luigismith/ichosynth/docs/README.md

# 📖 docs

| Folder | What |
|---|---|
| [`manuals/`](manuals) | the three manuals, each in **English** and **Italian**, as Markdown and PDF |
| [`wiring/`](wiring) | 🔌 the illustrated wiring guide [`CABLAGGIO.pdf`](wiring/CABLAGGIO.pdf) (Italian), every wire drawn on the real parts |
| [`reference/`](reference) | 🎛️ [control map](reference/MAPPA_CONTROLLI.md) and [feature inventory](reference/FEATURE_INVENTORY.md) |
| [`workshop/`](workshop) | 🎓 ICHOS 2026 workshop material: slides, handout, teacher notes |
| [`HANDOFF.md`](HANDOFF.md) | notes for whoever picks the project up (Italian) |

| Manual | 🇬🇧 English | 🇮🇹 Italiano |
|---|---|---|
| 🔧 **Build**: parts, soldering, wiring, case, firmware | [read](manuals/BUILD_MANUAL.md) · [PDF](manuals/BUILD_MANUAL.pdf) | [leggi](manuals/MANUALE_COSTRUZIONE.md) · [PDF](manuals/MANUALE_COSTRUZIONE.pdf) |
| 🎛️ **Usage**: how to play it | [read](manuals/USAGE_MANUAL.md) · [PDF](manuals/USAGE_MANUAL.pdf) | [leggi](manuals/MANUALE_USO.md) · [PDF](manuals/MANUALE_USO.pdf) |
| 💻 **Dev environment**: build the firmware yourself | [read](manuals/DEV_ENVIRONMENT.md) · [PDF](manuals/DEV_ENVIRONMENT.pdf) | [leggi](manuals/MANUALE_AMBIENTE.md) · [PDF](manuals/MANUALE_AMBIENTE.pdf) |

The case assembly guide (pictures only) lives with the case: [`case/MONTAGGIO.pdf`](../case/MONTAGGIO.pdf).
The PDFs are rebuilt from the Markdown by [`tools/pdf/`](../tools/pdf).
