luigismith/ichosynth/docs/workshop/README.md

# 🎓 Workshop ICHOS 2026: materiali

Materiali della giornata di costruzione di **ICHOS 2026** (Taranto, 12 giugno 2026), in italiano.

| File | Per chi | Cosa |
|---|---|---|
| [`ICHOSYNTH_Costruzione.pptx`](ICHOSYNTH_Costruzione.pptx) | docente | slide della giornata, con le note per il relatore |
| [`APPUNTI_DOCENTE.md`](APPUNTI_DOCENTE.md) · [PDF](APPUNTI_DOCENTE.pdf) | docente | scaletta e promemoria in un foglio |
| [`FASCICOLO_CORSISTA.pdf`](FASCICOLO_CORSISTA.pdf) | corsisti | il fascicolo da consegnare |
| [`QUICKSTART_COSTRUZIONE.md`](QUICKSTART_COSTRUZIONE.md) · [PDF](QUICKSTART_COSTRUZIONE.pdf) | corsisti | la checklist da tenere sul banco |
| [`INTRO_TEENSY_E_CODICE.md`](INTRO_TEENSY_E_CODICE.md) · [PDF](INTRO_TEENSY_E_CODICE.pdf) | corsisti | cos'è un Teensy e come si legge il codice, per chi parte da zero |

Le guide complete sono nei [manuali](..) (costruzione e uso), nella
[guida illustrata al cablaggio](../wiring/CABLAGGIO.pdf) e nella
[guida al montaggio del case](../../case/MONTAGGIO.pdf).
