luigismith/ichosynth/docs/workshop/QUICKSTART_COSTRUZIONE.md

# 🛠️ ichosynth — Quick-start da banco

### Guida rapida di costruzione · ICHOS 2026 · Taranto

> Tienila accanto al banco. Spunta ogni casella man mano. La guida completa è nel
> **Manuale di Costruzione**; qui c'è solo l'essenziale per montare e accendere.

---

## ✅ 1 · Componenti sul banco (BOM)

- [ ] **Teensy 4.1** con **PSRAM** (2× 8 MB) già saldata — *obbligatoria* (TŒRN usa ~16,5 MB)
- [ ] **Teensy Audio Adaptor Rev D** (codec SGTL5000 + jack 3,5 mm)
- [ ] **Matrice LED WS2812B 16×16** (256 LED)
- [ ] **4 encoder KY-040** (E1 · E2 · E3 · E4)
- [ ] **3 tact switch** 6×6 momentanei (PLAY · MENU · REC) — **alti 4,3 mm** se usi il case
- [ ] **1 jack mono 6,35 mm** (LINE IN, per registrare) → pad LINE IN L della scheda audio
- [ ] *(facoltativo)* **case stampato 3D** → `case/MONTAGGIO.pdf` (+ 8 viti M3×8 svasate, 4 piedini)
- [ ] **OLED SSD1306 0,96" I2C** (HUD di stato)
- [ ] **micro SD** Class 10, ≤ 32 GB, **FAT32**
- [ ] **cavo micro-USB dati** + alimentatore 5V ≥ 2A
- [ ] **cuffie** con jack 3,5 mm (niente altoparlanti a bordo)
- [ ] filo AWG 26 colorato, 2 strisce di header maschi **lunghi**, 2 morsetti a leva (WAGO 221) per 3V3/GND
- [ ] 📄 **guida illustrata al cablaggio: `docs/wiring/CABLAGGIO.pdf`** (un filo alla volta)

---

## 📌 2 · Mappa pin (la "verità" del firmware)

```
LED matrix DIN ........... 17          Audio MCLK ... 23    Audio SDA ... 18
                                       Audio BCLK ... 21    Audio SCL ... 19
Encoder E1   CLK 5   DT 22  SW 15      Audio LRCLK .. 20
Encoder E2   CLK 32  DT 33  SW 41      Audio TX ..... 7
Encoder E3   CLK 9   DT 14  SW 16      Audio RX ..... 8
Encoder E4   CLK 37  DT 38  SW 39      OLED ......... SDA 18 / SCL 19 (0x3C)
Pulsanti     PLAY 25   MENU 26   REC 28   →  l'altro capo a GND
```

⚡ **Alimentazioni:** matrice = **5V** · encoder/OLED/audio = **3,3V** · **GND sempre in comune.**
Encoder: pin **"+" → 3,3V**, **GND → GND**. (La 2ª striscia LED reattiva di TŒRN
**non si monta** in questa build: pin 24 libero.)

---

## 🔌 3 · Montaggio passo-passo

**Fase 1 — Teensy**
- [ ] PSRAM saldata (o Teensy che la ha già) · header saldati
- [ ] collega USB → il PC lo riconosce

**Fase 2 — Scheda audio**
- [ ] **impila** la scheda audio sul Teensy (più semplice) *oppure* cabla i segnali (7,8,20,21,23,18,19)
- [ ] cuffie nel jack 3,5 mm

**Fase 3 — Matrice LED**
- [ ] trova la **freccia di INGRESSO** dati → pin **17** (l'uscita resta libera)
- [ ] **5V** e **GND** della matrice

**Fase 4 — Encoder ×4** (E1 → E2 → E3 → E4)
- [ ] per ognuno: CLK, DT, SW come da mappa + "+" (3,3V) e GND
- [ ] etichetta i fili: **incrociare CLK/DT è l'errore #1** (gira al contrario → si scambiano)

**Fase 5 — Pulsanti ×3 e OLED**
- [ ] pulsanti: un capo a **25 (PLAY) / 26 (MENU) / 28 (REC)**, l'altro a **GND** (pull-up interno, niente resistenze)
- [ ] OLED in parallelo su SDA 18 / SCL 19, VCC 3,3V, GND

**Fase 6 — Controllo prima di accendere** 🔴
- [ ] multimetro: **nessun corto** 5V–GND e 3,3V–GND
- [ ] 5V / 3,3V / GND nei pin giusti

---

## ⚡ 4 · Caricare il firmware (flasher in un clic)

- [ ] collega il Teensy via USB
- [ ] apri **`tools/flasher/flasher.exe`** (al primo avvio Windows SmartScreen → *Ulteriori informazioni → Esegui comunque*)
- [ ] premi **⚡ Flash ichosynth**
- [ ] quando l'app lo chiede, premi una volta il **pulsantino PROGRAM** sul Teensy
- [ ] attendi *"Firmware scritto e Teensy riavviato"* ✅

> Niente Arduino/arduino-cli per chi flasha: il firmware ichosynth (TŒRN) è già
> dentro l'app. Per ricompilarlo dai sorgenti: `python firmware/build_toern.py`
> (vedi `firmware/README.md`).

---

## 💾 5 · Preparare la SD (campioni)

- [ ] modo più rapido: copia il contenuto di **`sdcard/`** sulla radice della SD (set già pronto)
- [ ] oppure apri **`tools/wavmaker/wavmaker.exe`** → **🔍 Scansiona** la SD (formatta FAT32 se serve)
- [ ] scegli **modalità**: *Samplepack* (8 voci → `<pack>/1-8.wav`) o *Libreria* (`samples/<cat>/<nome>.wav`)
- [ ] **Aggiungi file/cartella** WAV → **Converti** (diventano mono · 16-bit · 44.1 kHz)

---

## ▶️ 6 · Primo avvio

- [ ] SD inserita · cuffie · alimenta via USB → **logo** sulla matrice
- [ ] icona **noSD** rossa? spegni, inserisci la SD, riaccendi
- [ ] muovi gli encoder → il cursore e i parametri rispondono (l'OLED mostra canale/modo/BPM)
- [ ] piazza una nota sulla griglia → senti il campione
- [ ] premi **PLAY** → la sequenza parte; **MENU** entra/esce dai menu; **REC** registra
- [ ] in DRAW, **ruota E4**: il suono della voce sotto il cursore si scurisce (filtro lowpass)

---

## 🆘 7 · Se qualcosa non va (top 5)

| Sintomo | Rimedio rapido |
|---|---|
| Non riconosciuto dal PC | cavo USB **dati** (non solo-carica); ricontrolla header / corto 5V-GND |
| Si riavvia da solo | PSRAM mancante/mal saldata (servono i 2 chip); alimentazione 5V ≥ 2A; **SD inserita** |
| LED spenti / colori errati | DIN non sul **17**; freccia dati invertita; GND non comune |
| Encoder "al contrario" | inverti **CLK e DT** di quell'encoder |
| Nessun suono | scheda audio (7,8,20,21,23,18,19); cuffie; volume |

---

<div align="center">

**Quando suona → Manuale d'Uso.** Buona costruzione! 🎛️
*ichosynth · build a basso costo di TŒRN (SP_) · firmware MIT*

</div>
