luigismith/ichosynth/design/foundations/typography.html

Tipografia

ichosynth

Titolo sezione (Segoe UI 700)

Sottotitolo / didascalia (Segoe UI, #9aa4b2)

Testo corrente. Il sistema usa Segoe UI per l'interfaccia e la documentazione, con un grigio tenue per le note secondarie.

Monospace — pin e codice

E1 5 / 22 / 15 E4 37 / 38 / 39 pulsanti 25 / 26 / 28

python firmware/build_toern.py → toern.hex
