luigismith/ichosynth/design/brand/logo.html

Logo / Lockup

🎛️ ichosynth

un TŒRN su hardware DIY · Teensy 4.1
