luigismith/ichosynth/assets/social-preview.jpg

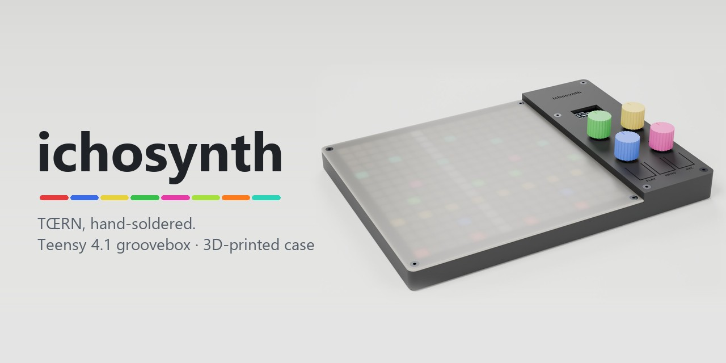
assets/social-preview.jpg
