luigismith/ichosynth/_DOCS/_PCB/ni404/production/bom.csv

Designator | Footprint | Quantity | Value | LCSC Part #
J11, J12, J13, J14, J15 | JST_PH_B5B-PH-K_1x05_P2.00mm_Vertical | 5 | Conn_01x05
J9 | JST_PH_B3B-PH-K_1x03_P2.00mm_Vertical | 1 | Conn_01x03
