luigismith/ichosynth/_DOCS/_PCB/ni404/ni404.csv

Id | Designator | Footprint | Quantity | Designation | Supplier and ref
1 | J15,J11,J12,J13,J14 | JST_PH_B5B-PH-K_1x05_P2.00mm_Vertical | 5 | Conn_01x05
2 | J9 | JST_PH_B3B-PH-K_1x03_P2.00mm_Vertical | 1 | Conn_01x03
