luigismith/ichosynth/_DOCS/_ENCLOSURE/ni404 completed.stl

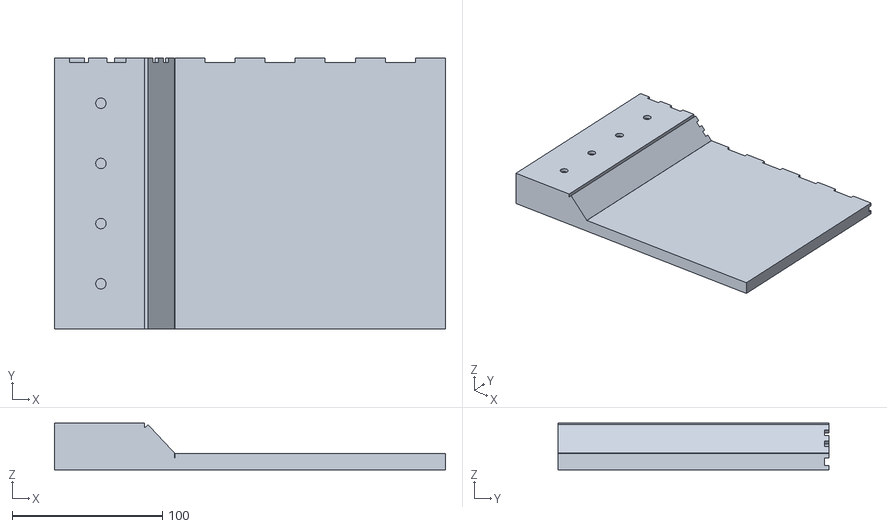
[picture p45: CAD file, 2026-05-21]
_DOCS/_ENCLOSURE/ni404 completed.stl
260.0 x 180.0 x 31.0
