luigismith/ichosynth/_CASE/stl/tray.stl

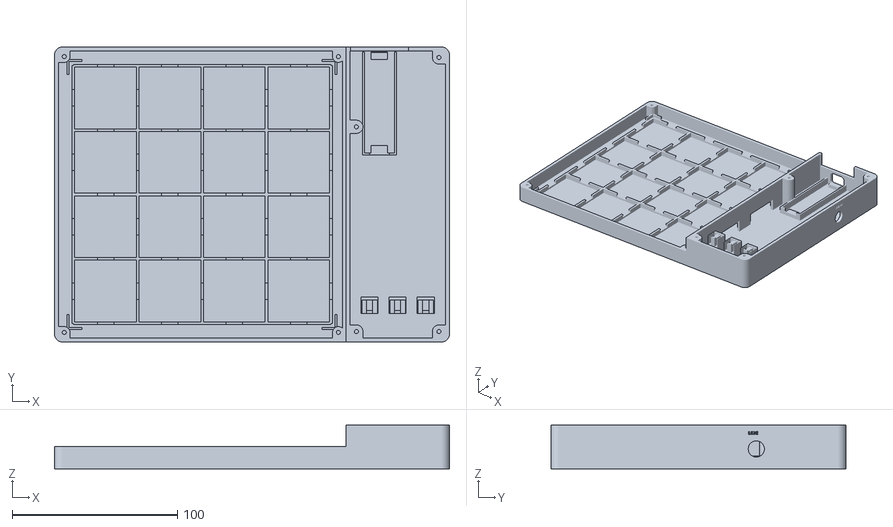
[picture p46: CAD file, 2026-10-30]
_CASE/stl/tray.stl
239.2 x 178.8 x 26.4
