luigismith/ichosynth/_DOCS/_ENCLOSURE/ni404_front.stl

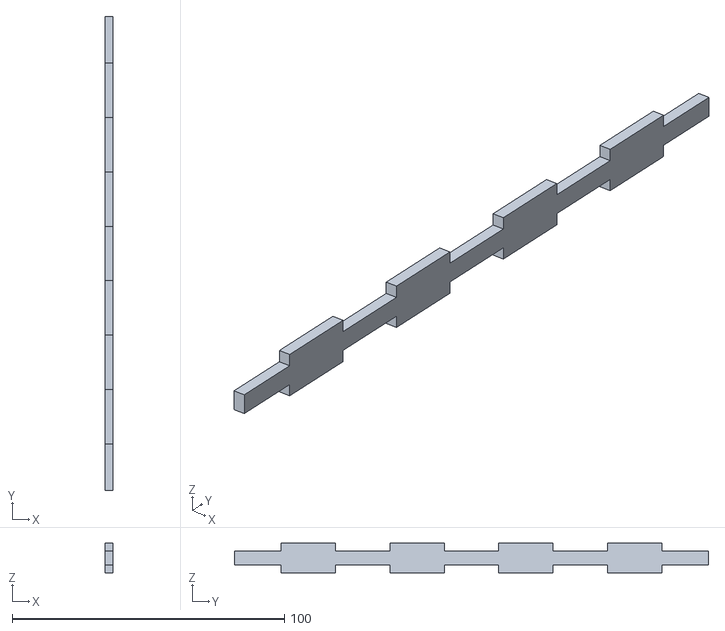
[picture p47: CAD file, 2026-05-21]
_DOCS/_ENCLOSURE/ni404_front.stl
3.00 x 174.0 x 11.0
