luigismith/ichosynth/_DOCS/_PCB/ni404/ni404.step

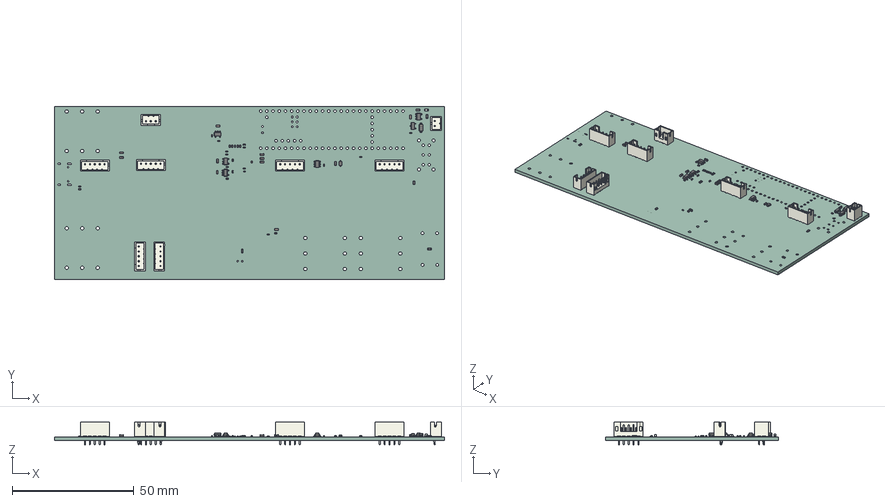
[picture p48: CAD file, 2026-05-21]
_DOCS/_PCB/ni404/ni404.step
160.0 x 71.0 x 9.40 mm
D_SOD_123
C_0402_1005Metric x 14
R_0603_1608Metric x 6
R_0402_1005Metric x 11
JST_B5B_PH_K x 6
C_0603_1608Metric x 10
SOT_23_6
SOT_23_5 x 4
JST_B3B_PH_K
LED_0603_1608Metric
SOT_23
JST_B2B_PH_K
D_SOD_323F
teensyAudioMidi_PCB
