luigismith/ichosynth/case/ichosynth_case_S1Combo_PETG.3mf

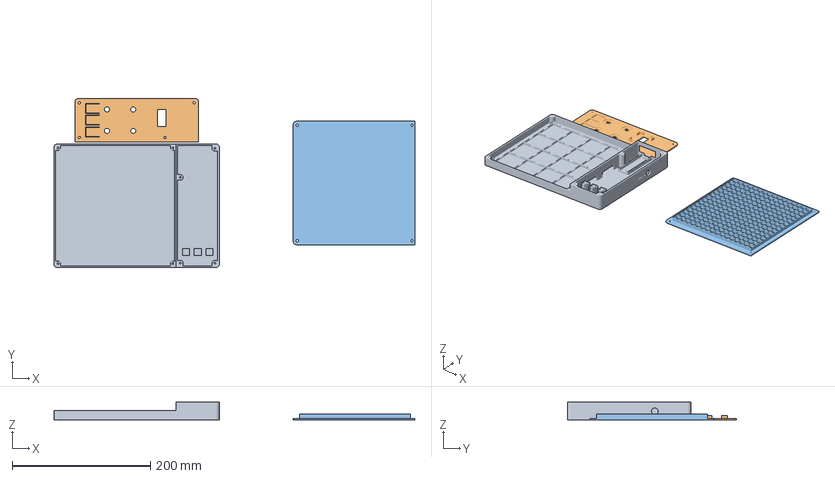
[picture p49: CAD file, 2026-11-05]
case/ichosynth_case_S1Combo_PETG.3mf
522.1 x 244.6 x 26.0 mm
vasca
pannello
diffusore
