luigismith/ichosynth/_CASE/stl/plate1.stl

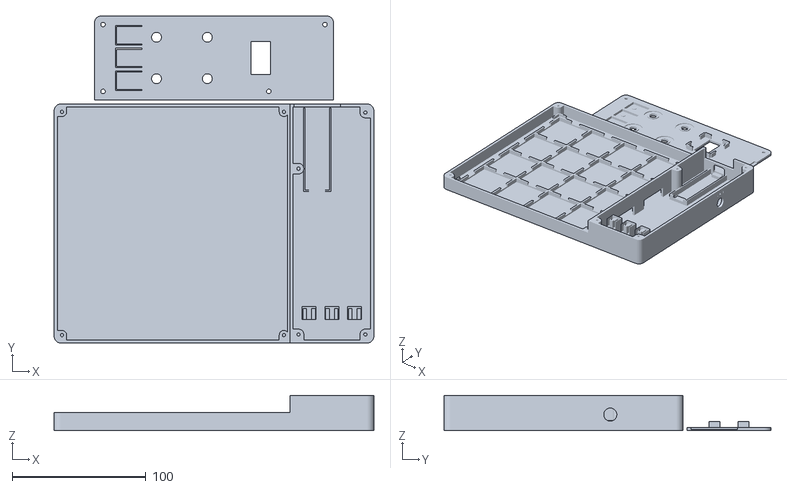
[picture p50: CAD file, 2026-10-30]
_CASE/stl/plate1.stl
239.2 x 244.6 x 26.4
