luigismith/ichosynth/_CASE/stl/window.stl

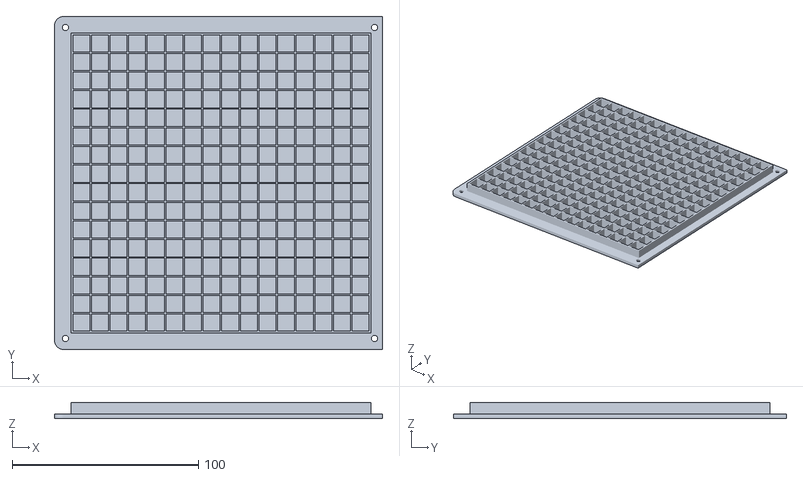
[picture p51: CAD file, 2026-10-30]
_CASE/stl/window.stl
176.2 x 178.8 x 8.60
