luigismith/ichosynth/_DOCS/_ENCLOSURE/ni404_frontplate.stl

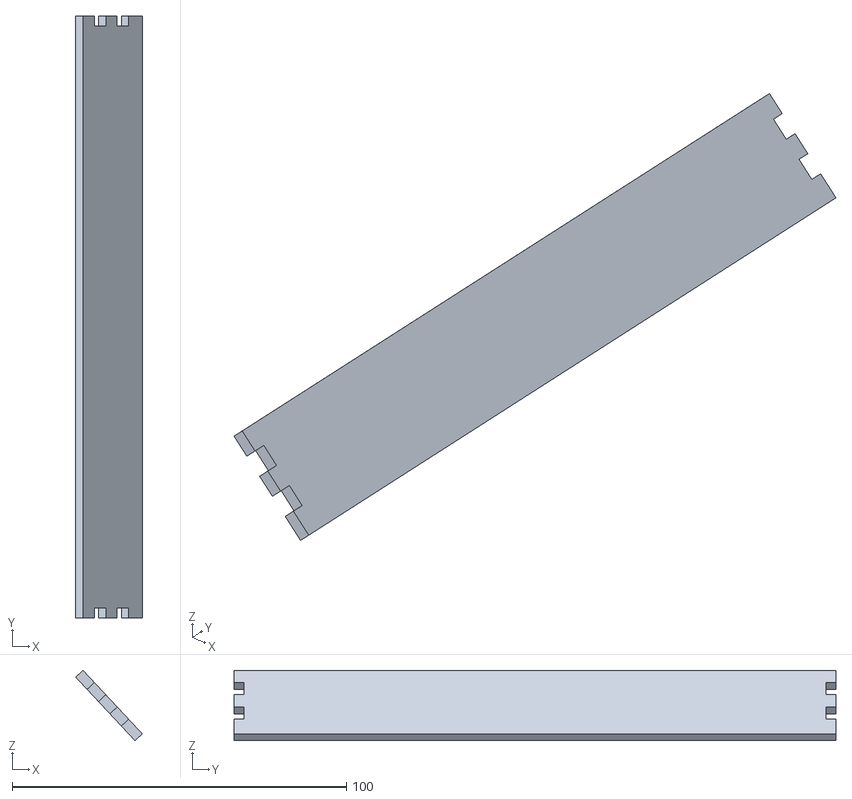
[picture p52: CAD file, 2026-05-21]
_DOCS/_ENCLOSURE/ni404_frontplate.stl
19.9 x 180.0 x 21.1
