luigismith/ichosynth/case/stl/panel.stl

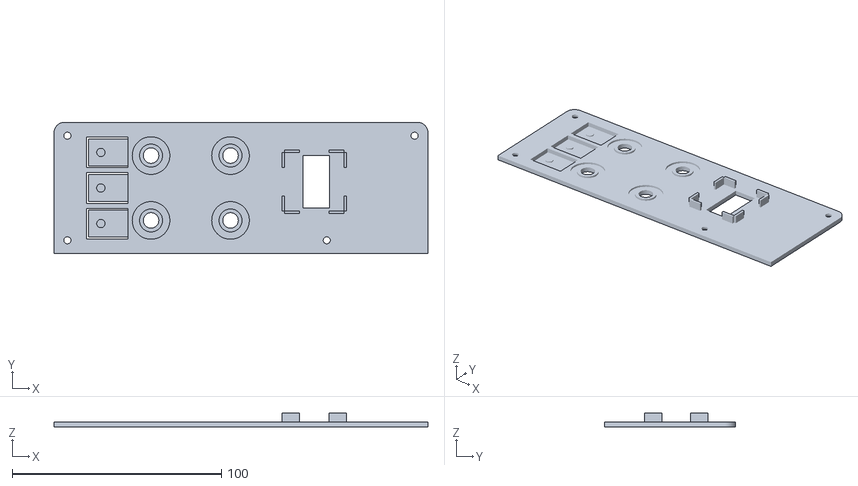
[picture p53: CAD file, 2026-11-04]
case/stl/panel.stl
178.8 x 62.8 x 6.70
