luigismith/ichosynth/_CASE/stl/knob.stl

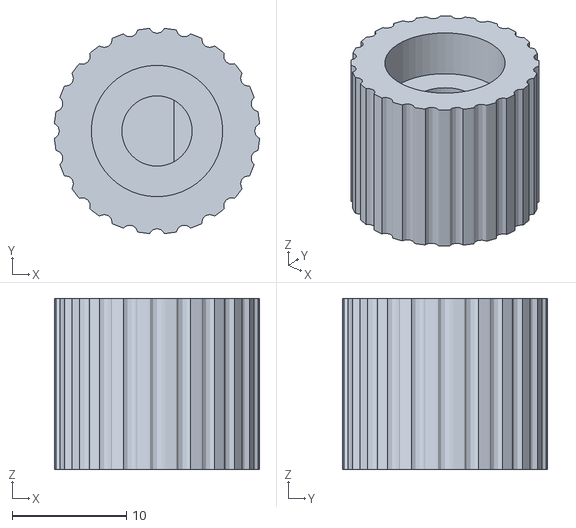
[picture p54: CAD file, 2026-10-30]
_CASE/stl/knob.stl
17.9 x 17.9 x 15.0
