luigismith/ichosynth/_DOCS/_ENCLOSURE/ni404_top.stl

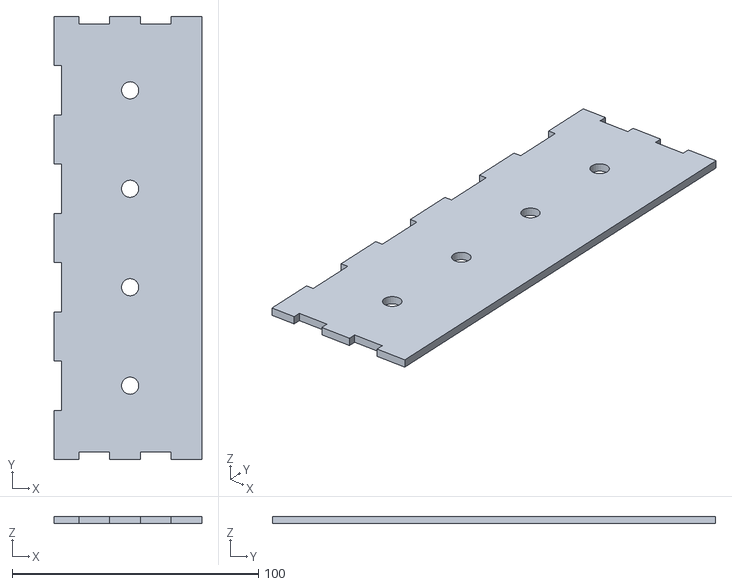
[picture p55: CAD file, 2026-05-21]
_DOCS/_ENCLOSURE/ni404_top.stl
60.0 x 180.0 x 3.00
