luigismith/ichosynth/_DOCS/_ENCLOSURE/ni404_back.stl

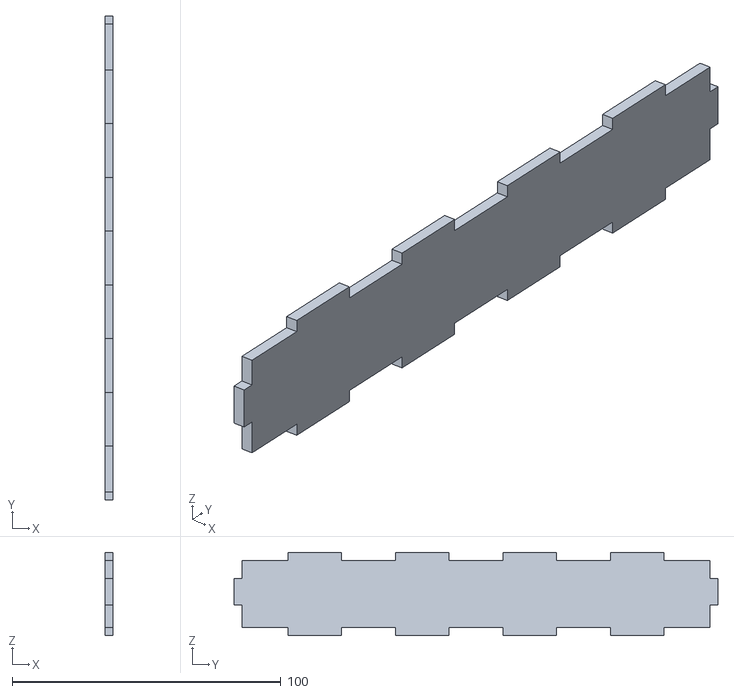
[picture p56: CAD file, 2026-05-21]
_DOCS/_ENCLOSURE/ni404_back.stl
3.00 x 180.0 x 31.0
