luigismith/ichosynth/_DOCS/_ENCLOSURE/ni404_glassplate.stl

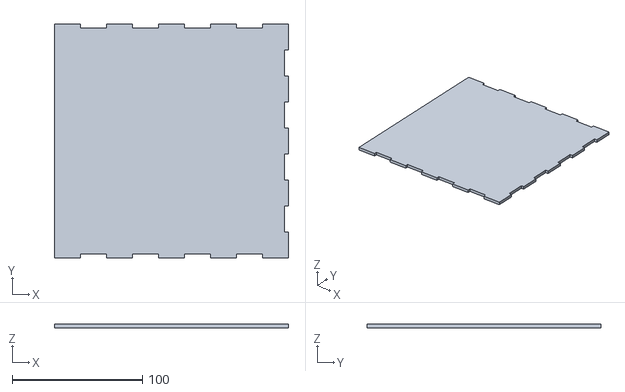
[picture p57: CAD file, 2026-05-21]
_DOCS/_ENCLOSURE/ni404_glassplate.stl
180.0 x 180.0 x 3.00
