luigismith/ichosynth/_DOCS/_ENCLOSURE/ni404_base.stl

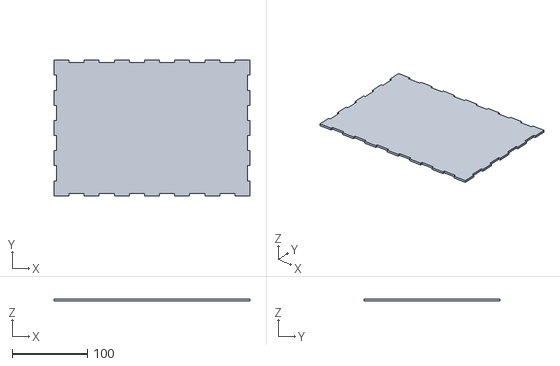
[picture p58: CAD file, 2026-05-21]
_DOCS/_ENCLOSURE/ni404_base.stl
260.0 x 180.0 x 3.00
