luigismith/ichosynth/_DOCS/_ENCLOSURE/ni404_sides.stl

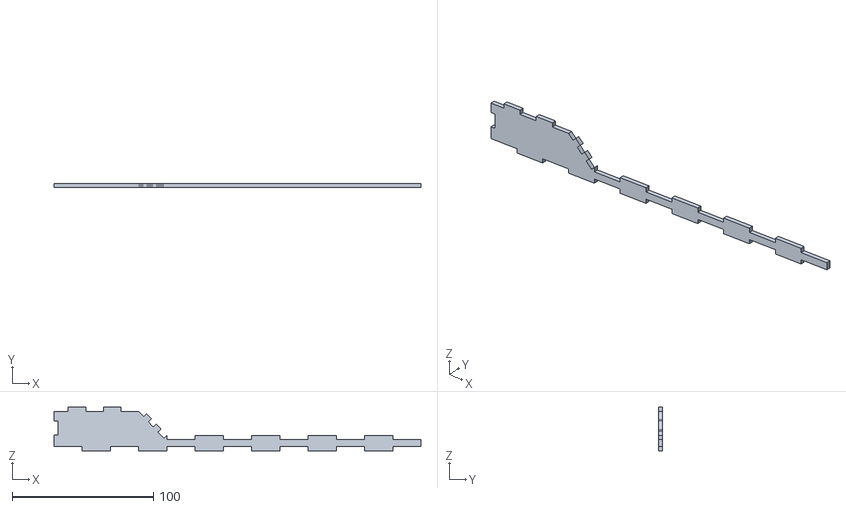
[picture p59: CAD file, 2026-05-21]
_DOCS/_ENCLOSURE/ni404_sides.stl
260.0 x 3.00 x 31.0
