luigismith/ichosynth/_DOCS/_ENCLOSURE/ni_404.dxf

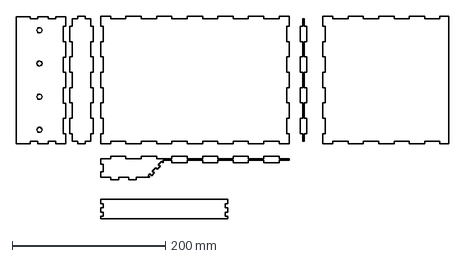
[picture p60: CAD file, 2026-05-21]
_DOCS/_ENCLOSURE/ni_404.dxf
564.2 x 264.5 mm
