luigismith/ichosynth/(list of files, cad)

Other CAD files:
case/stl/tray.stl
case/ichosynth_case_S1Combo.3mf
case/stl/plate1.stl
_CASE/ichosynth_case_S1Combo.3mf
_CASE/ichosynth_case_S1Combo_PETG.3mf
_DOCS/_ENCLOSURE/ni_404.f3d
