luigismith/ichosynth/MANUALE_AMBIENTE.md

**🇮🇹 Italiano** · [🇬🇧 English](DEV_ENVIRONMENT.md)

<div align="center">

# 💻 ichosynth — Ambiente di sviluppo

### Guida completa e aggiornata per Windows e macOS

Tutto il necessario per compilare, modificare e caricare il firmware: dalla toolchain alle librerie, fino al primo upload sul Teensy 4.1.






</div>

> ⚡ **Hai fretta?** ichosynth esegue il firmware reale **TŒRN**, e un solo comando lo compila per il nostro
> hardware: `python teensy/build_toern.py`. Vai al [capitolo 3](#3--via-rapida-un-comando-compila-tutto). Il
> resto della guida spiega ogni passo e prerequisito.

---

## 📑 Indice

- [1 · Cosa installiamo](#1--cosa-installiamo)
- [2 · Requisiti](#2--requisiti)
- [3 · Via rapida: un comando compila tutto](#3--via-rapida-un-comando-compila-tutto)
- [4 · Installare la toolchain (arduino-cli)](#4--installare-la-toolchain-arduino-cli)
- [5 · Aggiungere il supporto Teensy (il core teensy:avr)](#5--aggiungere-il-supporto-teensy-il-core-teensyavr)
- [6 · Le librerie](#6--le-librerie)
- [7 · Come funziona lo script di build](#7--come-funziona-lo-script-di-build)
- [8 · Compilare e caricare](#8--compilare-e-caricare)
- [9 · Compilare dall'Arduino IDE (alternativa)](#9--compilare-dallarduino-ide-alternativa)
- [10 · Strumenti opzionali (Python, Git)](#10--strumenti-opzionali-python-git)
- [11 · Checklist e problemi comuni](#11--checklist-e-problemi-comuni)

---

## 1 · Cosa installiamo

ichosynth è un **Teensy 4.1** che esegue il firmware reale **TŒRN** (di SP_ / soundpauli — <https://toern.live>)
su componenti economici saldati a mano. Nel repo non teniamo una copia separata di TŒRN: uno script di build
scarica i sorgenti originali e li compila per il nostro hardware. Ecco cosa serve:

| Componente | Versione | A cosa serve | Obbligatorio |
|---|---|---|---|
| **arduino-cli** | ultima | la toolchain di build da riga di comando | ✅ |
| **core teensy:avr** | **≥ 1.61.0** | il compilatore Teensy + il Teensy Loader | ✅ |
| **Python** | 3.x | esegue `teensy/build_toern.py` (lo script di build) | ✅ |
| **Git** | ultima | lo script clona i sorgenti TŒRN alla prima esecuzione | ✅ |
| **Driver personalizzati** | nel repo | `i2cEncoderLibV2`, `FastTouch`, `IchosOled` — già in `teensy/libraries/` | ✅ (inclusi) |
| **GitHub CLI** | ultima | opzionale, per versionare il progetto | opzionale |

> ⚙️ **L'unica trappola che frega tutti:** TŒRN è un'unica unità di compilazione da ~23k righe, e il gcc del
> Teensy **va in crash con il `-O2` di default** (esce con `0xffffffff` — un internal compiler error /
> out-of-memory). La soluzione è compilare a **`-O1`** (`opt=o1std`). Lo script di build lo imposta per te; se
> invece compili dall'Arduino IDE devi scegliere **Tools → Optimize → "Fast"**. Vedi il
> [capitolo 7](#7--come-funziona-lo-script-di-build).

---

## 2 · Requisiti

- **Windows**: Windows 10 o 11, 64 bit.
- **macOS**: macOS 10.15 o successivo; supporto nativo **Intel** e **Apple Silicon** (M1/M2/M3/M4).
- **Cavo micro-USB dati** (non solo-carica) per il Teensy 4.1.
- Un **Teensy 4.1 con 16 MB di PSRAM** (entrambi i chip) saldati — TŒRN usa la PSRAM per i buffer dei campioni.
- ~1 GB di spazio su disco per toolchain + core + librerie.

---

## 3 · Via rapida: un comando compila tutto

Una volta che hai **arduino-cli**, il **core teensy:avr**, **Python** e **Git** (capitoli 4–5), compilare il
firmware è un solo comando dalla radice del repo:

```bash
python teensy/build_toern.py
```

Questo produce il firmware in **`teensy/firmware/toern.hex`**. Per compilare *e* flashare in un colpo solo (se
`teensy_loader_cli` è nel tuo PATH):

```bash
python teensy/build_toern.py --flash
```

Flag utili:

| Flag | Effetto |
|---|---|
| `--flash` | dopo la compilazione, carica con `teensy_loader_cli` |
| `--keep` | mantiene la cartella di build temporanea (per ispezionare i sorgenti preparati/patchati) |

> 💡 La **prima** compilazione è lenta (il core Teensy viene compilato una volta) e inoltre **clona i sorgenti
> TŒRN** in `emulator/toern-src/` se non ci sono ancora. Le compilazioni successive sono rapide.
>
> 🖱️ Vuoi solo flashare un `.hex` **già pronto**? C'è un flasher GUI a un clic in **`_FLASHER/`** — vedi il
> [capitolo 8.3](#83-flashare-il-firmware).

---

## 4 · Installare la toolchain (arduino-cli)

Compiliamo da riga di comando con **[`arduino-cli`](https://arduino.github.io/arduino-cli/)**.

### Windows
```powershell
winget install ArduinoSA.CLI
```

### macOS
```bash
brew install arduino-cli
```

Verifica che sia nel PATH:
```bash
arduino-cli version
```

> ℹ️ **Driver**: su Windows 10/11 e su macOS **non servono driver aggiuntivi** per il Teensy 4.1.

---

## 5 · Aggiungere il supporto Teensy (il core teensy:avr)

Il compilatore Teensy e il Teensy Loader arrivano dal **core teensy:avr**. Aggiungi l'indice dei pacchetti di
PJRC, aggiorna e installa il core (ci serve la **versione ≥ 1.61.0**):

```bash
arduino-cli config init
arduino-cli config add board_manager.additional_urls https://www.pjrc.com/teensy/package_teensy_index.json
arduino-cli core update-index
arduino-cli core install teensy:avr
```

Controlla la versione che hai ottenuto:
```bash
arduino-cli core list
```
Dovresti vedere `teensy:avr` alla **1.61.0** o successiva.

> 💡 Preferisci una GUI? In alternativa puoi installare **Teensyduino 1.61** dal Boards Manager dell'Arduino
> IDE 2.x (URL del pacchetto PJRC qui sopra): installa lo stesso core `teensy:avr`. In entrambi i casi, allo
> script di build serve solo che il core sia presente e `arduino-cli` nel PATH.

---

## 6 · Le librerie

Il firmware TŒRN si compila contro tre **driver personalizzati** che lo adattano al nostro hardware economico.
Sono **già nel repo** sotto `teensy/libraries/`, e lo script di build li indica ad `arduino-cli`
automaticamente — non devi installarli:

| Libreria | Sostituisce | Dove sta la configurazione hardware |
|---|---|---|
| **i2cEncoderLibV2** | i 4 encoder RGB I²C di TŒRN → i nostri 4 encoder meccanici KY-040 | `ICHOS_ENC_PINS` in `i2cEncoderLibV2.h` |
| **FastTouch** | i 3 pad capacitivi di TŒRN → i nostri 3 pulsanti tattili momentanei | `ICHOS_BTN_PINS` in `FastTouch.h` |
| **IchosOled** | aggiunge l'**HUD OLED** I²C (lo stato che TŒRN mostrava sugli anelli RGB degli encoder) | `teensy/libraries/IchosOled/` |

> 🧭 **Dove vive l'hardware:** l'assegnazione dei pin sta in quei due header (`ICHOS_ENC_PINS`,
> `ICHOS_BTN_PINS`) e in `teensy/build_toern.py` — **non** in un `config.h`. (`config.h` appartiene alla vecchia
> build di fallback NI404 e non viene usato dal port TŒRN.)

Lo script di build risolve anche le eventuali librerie standard rimanenti (le **Audio**, **Wire**, **SD**, ecc.
incluse nel core Teensy, più qualsiasi cosa nella tua `Arduino/libraries/` utente) come fa normalmente
`arduino-cli`.

---

## 7 · Come funziona lo script di build

`teensy/build_toern.py` compila lo sketch TŒRN **non modificato**, applicando solo le modifiche minime che lo
fanno girare sul nostro hardware. Passo per passo:

1. **Trova i sorgenti.** Cerca lo sketch TŒRN sotto `emulator/toern-src/`; se non c'è, lo **clona**
   automaticamente dall'upstream (così il repo resta privo di una copia interna).
2. **Li prepara** in una cartella di build temporanea (gli originali restano intatti).
3. **Remap dei pin.** I `SWITCH_1/2/3` di TŒRN puntano di default a pin che collidono con il nostro KY-040 di
   destra, quindi vengono rimappati a **25 / 26 / 28** — gli stessi pin di `ICHOS_BTN_PINS` in `FastTouch.h`.
4. **Snellimento funzioni.** Rimuove la **seconda striscia LED** opzionale (libera un pin e risparmia CPU),
   come nel nostro build.
5. **HUD OLED.** Cabla la libreria `IchosOled` (include + `begin()` + una chiamata di rendering su una riga nel
   `loop()`) così che l'HUD di stato compili come unità di compilazione separata.
6. **Compila** con `arduino-cli` per l'FQBN qui sotto e copia il risultato in un nome stabile, `toern.hex`.

Il target esatto per cui compila è:

```text
teensy:avr:teensy41:usb=serialmidi16,opt=o1std
```

- `usb=serialmidi16` → **USB type Serial + MIDIx16** (così `usbMIDI` funziona).
- `opt=o1std` → **`-O1`**. È il flag critico: il `-O2` di default fa crashare il gcc del Teensy sull'enorme
  unità di compilazione singola di TŒRN. Il `-O1` compila pulito e il firmware ci sta comunque con margine.

---

## 8 · Compilare e caricare

### 8.1 Compilare
Dalla radice del repo:
```bash
python teensy/build_toern.py
```
Al termine avrai **`teensy/firmware/toern.hex`**.

### 8.2 Compilare e flashare in un passo
Se hai `teensy_loader_cli` nel PATH:
```bash
python teensy/build_toern.py --flash
```
1. Collega il Teensy 4.1 via USB (cavo **dati**).
2. Il loader di solito programma da solo; se resta in attesa, premi il **pulsantino bianco** sul Teensy.
3. A fine flash parte l'animazione sulla matrice LED.

### 8.3 Flashare il firmware
Se preferisci flashare un `.hex` **già pronto** (o non hai `teensy_loader_cli`), usa il **flasher GUI a un
clic** in **`_FLASHER/`** — puntalo a `teensy/firmware/toern.hex` e clicca flash.

---

## 9 · Compilare dall'Arduino IDE (alternativa)

Puoi anche compilare TŒRN a mano nell'Arduino IDE 2.x — utile per studiare il codice passo passo. Devi
riprodurre quello che fa lo script:

| Voce del menu Tools | Valore |
|---|---|
| **Board** | Teensy 4.1 |
| **USB Type** | **Serial + MIDIx16** |
| **CPU Speed** | 600 MHz (default) |
| **Optimize** | **"Fast"** ⚠️ (è il `-O1`; il default "Faster"/`-O2` fa crashare il compilatore) |
| **Port** | la porta del Teensy (dopo il collegamento) |

Dovrai inoltre applicare il remap dei pin (`SWITCH_1/2/3` → 25/26/28), rendere visibili all'IDE le tre librerie
personalizzate in `teensy/libraries/` e cablare a mano l'HUD OLED. **Lo script fa tutto questo per te**, ed è
per questo che è il percorso consigliato.

> ⚠️ Non dimenticare **Optimize → "Fast"**. Se lo lasci sul default, la build muore con un internal compiler
> error (`exit 0xffffffff`) a metà dell'unico file enorme di TŒRN.

---

## 10 · Strumenti opzionali (Python, Git)

### 10.1 Python
Allo script di build serve **Python 3**. (Serve anche Git — vedi sotto — perché lo script clona i sorgenti
TŒRN alla prima esecuzione.)

**Windows:** `winget install Python.Python.3.12`  · **macOS:** `brew install python@3.12`

> ℹ️ Per lo script di build va bene qualsiasi Python 3 moderno. (Se usi anche il convertitore di campioni
> `wavmaker` e lo esegui dai sorgenti su **Python 3.13+**, quello richiede `pip install audioop-lts`, perché
> `audioop` è stato rimosso dalla libreria standard — ma il `wavmaker.exe` pronto in `_SDCARD/` non richiede
> Python.)

### 10.2 Git e GitHub CLI
Git è obbligatorio (lo script clona TŒRN). GitHub CLI è opzionale.

**Windows:** `winget install Git.Git` (+ `GitHub.cli` opzionale)
**macOS:** `xcode-select --install` (include git) · `brew install gh` (opzionale)

---

## 11 · Checklist e problemi comuni

| ✓ | Controllo |
|---|---|
| ☐ | `arduino-cli version` funziona (è nel PATH) |
| ☐ | `arduino-cli core list` mostra **teensy:avr ≥ 1.61.0** |
| ☐ | **Python 3** e **Git** sono installati |
| ☐ | `python teensy/build_toern.py` produce `teensy/firmware/toern.hex` |
| ☐ | (solo build da IDE) USB Type = Serial + MIDIx16 **e** Optimize = "Fast" |
| ☐ | Il Teensy 4.1 ha **16 MB di PSRAM** saldati |

| Sintomo | Causa / soluzione |
|---|---|
| `arduino-cli not on PATH …` dallo script | installa arduino-cli (cap. 4) e riapri il terminale |
| La compilazione muore con `exit 0xffffffff` / internal compiler error | hai compilato a `-O2`; usa lo script, oppure imposta Optimize → "Fast" (`-O1`) nell'IDE |
| `teensy:avr` mancante / troppo vecchio | esegui `arduino-cli core install teensy:avr` e controlla `core list` (serve ≥ 1.61.0) |
| Lo script non riesce a clonare i sorgenti TŒRN | installa Git, oppure clona a mano in `emulator/toern-src/` |
| `'usbMIDI' was not declared` (build da IDE) | USB Type non su Serial + MIDIx16 |
| `teensy_loader_cli not found` con `--flash` | usa invece il flasher GUI in `_FLASHER/` |
| Il Teensy non si programma | premi il **pulsante bianco** sulla scheda; oppure usa un cavo USB **dati**, non solo-carica |
| Porta non visibile | cavo USB solo-carica → usa un cavo dati |

---

<div align="center">

*Parte del progetto **[ichosynth](README.it.md)** · esegue il firmware reale **TŒRN** (SP_) · per il workshop ICHOS 2026.*

</div>
