luigismith/ichosynth/emulator/MANUALE.md

# Emulatore ichosynth — Manuale utente

Emulatore desktop (Windows e macOS) usato come **banco di prova** per ichosynth.
Esegue un **firmware reale** ricompilato in modo nativo: la stessa logica che gira
sull'hardware, ma sul computer, con la griglia LED 16×16, il display OLED, l'audio
e i controlli su tastiera/mouse e controller MIDI.

> Lo **strumento fisico** ichosynth fa girare il **firmware reale di TŒRN** (si
> compila con `firmware/build_toern.py`). L'emulatore può eseguire **lo stesso
> sorgente TŒRN** nel target `toernemu` (riferimento, §10), utile per provare la
> mappatura dei controlli prima dell'hardware. Il target di default `ni404emu` è
> invece il **firmware-banco** (l'ibrido a 4 encoder, `legacy/soundpauli_ni404/soundpauli_ni404.ino`) con
> cui prototipiamo velocemente le feature in stile TŒRN su PC.

| Programma | Cosa esegue |
|---|---|
| `ni404emu` | Il firmware-banco di ichosynth (`legacy/soundpauli_ni404/soundpauli_ni404.ino`) + OLED SSD1306 — **build di default** |
| `toernemu` | Il firmware **TŒRN** reale (quello dello strumento fisico) — **riferimento**, NON compilato di default (vedi §10) |

---

## 1. Avvio rapido

### Con il launcher (consigliato) — compila e lancia tu il firmware

Dalla cartella del repository, un solo comando compila (se serve) e avvia l'emulatore
col firmware che vuoi provare. Trova da solo il toolchain MSYS2/MinGW64 e, se mancano,
scarica i sorgenti di TŒRN.

```
python emulator/run.py            # firmware del PRODOTTO: il TŒRN reale (toernemu)
python emulator/run.py --bench    # firmware-banco di fallback (ni404emu)
python emulator/run.py --rebuild  # ricompila da zero prima di lanciare
python emulator/run.py --build-only   # compila soltanto, non avvia
```

È così che provi le **varianti del synth sullo stesso hardware**: modifichi il firmware
(o le rimozioni di feature), rilanci `python emulator/run.py` e lo strumento riparte con
la variante — la stessa che poi flashi sul Teensy con `firmware/build_toern.py`.

### Windows (eseguibile già compilato)
1. Apri la cartella `emulator\build\` (o `emulator\playable-2026-06-13\`).
2. Doppio clic su **`toernemu.exe`** (il TŒRN reale) o **`ni404emu.exe`** (il banco).
   - Tutto il necessario è già lì accanto (`SDL2.dll` e le altre librerie).
3. Si apre la finestra con la griglia LED in alto e il display OLED in basso.

Per far partire subito un brano dimostrativo:
```
ni404emu.exe --demo
```

### macOS
Il binario macOS va generato su un Mac (vedi §10). Una volta compilato:
```
./build/ni404emu            # avvio normale
./build/ni404emu --demo     # con la demo
```

> L'emulatore legge i campioni dalla cartella `sdcard` del repository (il percorso
> è fissato al momento della compilazione). Non spostarla.

---

## 2. La finestra

- **In alto**: la **griglia LED 16×16** (la stessa matrice WS2812 dell'hardware).
  Mostra il pattern del sequencer, i numeri, i menu del firmware.
- **Al centro**: il **display OLED 128×64** (status HUD: modo, BPM, volume,
  velocity, pagina, play/stop/**\*REC\***). È piccolo e centrato, in proporzione
  realistica rispetto alla matrice (il modulo 0,96" reale è minuscolo).
- **In basso**: il **pannello comandi a schermo** — 4 **manopole** (E1–E4) e
  **3 pulsanti** (**PLAY / MENU / REC**) — usabili con **mouse o dito** (vedi §3),
  così su un dispositivo touch la simulazione è realistica. *(Il filtro è sulla
  rotazione del 4° encoder, alla TŒRN: niente pulsante dedicato.)*

L'orientamento della griglia rispecchia il pannello fisico (riga 1 in basso).

---

## 3. Controlli

### A schermo (mouse / touch) — pannello in basso
- **Manopole E1–E4**:
  - **trascina sul bordo (anello)** = **ruota** (solo rotazione); l'indicatore gira.
  - **premi al centro** = premi il pulsante dell'encoder.
  - **premi al centro e trascina** = tieni premuto **e** ruoti insieme (gesto
    "premi + ruota" in un colpo). C'è una piccola zona morta al centro così un
    semplice click non fa ruotare per sbaglio.
  - rotellina del mouse sopra una manopola = ruota.
  - in DRAW/SINGLE, la rotazione del **4° encoder (E4)** = **filtro** (cutoff)
    lowpass della voce sotto il cursore — alla TŒRN, niente pulsante.
- **Pulsanti**: **PLAY** (play/pausa), **MENU** (tap = entra/esci menu; **tieni
  premuto** = **FX MODE**), **REC** (tieni premuto per registrare, vedi §9).
- **FX MODE** (tieni MENU in DRAW/SINGLE): le 4 manopole diventano **slider** della
  voce sotto il cursore — E1 cutoff, E2 ladder cutoff, E3 ladder risonanza, E4
  bitcrush — mostrati come 4 barre sulla griglia. Tap MENU per uscire.
- Tutto funziona con il **multi-touch** (puoi premere due pulsanti insieme).

### Da tastiera del PC

| Tasto | Funzione |
|---|---|
| **Q / A** · **W / S** · **E / D** · **R / F** | Encoder 1 · 2 · 3 · 4 — ruota indietro / avanti |
| **Z · X · C · V** | Premi encoder 1 · 2 · 3 · 4 |
| **R / F** | 4° encoder = **filtro** (cutoff) della voce sotto il cursore |
| **1 / 2 / 3** | Pulsanti **PLAY / MENU / REC** |
| **TAB** | Apre/chiude il **menu impostazioni** |
| **Esc** | Esci |

> **Niente reagisce ai tasti?** Clicca prima sulla **finestra grafica** per darle il
> focus (i click del mouse sui comandi funzionano comunque sempre).

---

## 4. Menu impostazioni (TAB)

Premi **TAB** per sovrapporre il menu. Navighi con le **frecce**:

- **↑ / ↓** — scegli la voce
- **← / →** — cambia il valore della voce selezionata
- **TAB** o **Esc** — chiudi

Voci:

| Voce | Cosa fa |
|---|---|
| **Uscita audio** | Sceglie la scheda/uscita audio (← → per scorrere i dispositivi) |
| **Volume** | Guadagno d'uscita 0×…64× (alza qui se senti basso) |
| **Ingresso audio** | Sceglie il microfono/linea **usato dalla registrazione** (§9) |
| **Cartella SD** | Mostra il percorso della SD; **Invio** la apre in Esplora file |
| **Ripristina SD** | **Invio** torna alla cartella SD predefinita (per cambiarla: trascina una cartella sulla finestra) |
| **Campioni SD** | **Invio** apre il **browser dei campioni** (§9) |
| **MIDI in** | Mostra i controller MIDI rilevati |
| **Mappa MIDI** | Ricorda dove si configura la mappatura (`midi-map.txt`) |
| **Tasti** | Legenda dei tasti |
| **Chiudi** | Chiude il menu |

Le impostazioni si salvano in **`settings.txt`** accanto all'eseguibile.

---

## 5. Audio

- Uscita predefinita del sistema all'avvio; cambiala dal menu (TAB → Audio output).
- Se senti **troppo piano**, alza **Master volume** nel menu (fino a 64×) oppure il
  volume interno dello strumento (encoder sinistro in modo BPM/VOL).
- La demo è tarata con un po' di headroom (picco ~0,9, niente clipping).

---

## 6. Controller MIDI

Collega un controller USB-MIDI **prima** di avviare l'emulatore: all'avvio apre
**tutte** le porte MIDI di ingresso (alcuni controller, come l'MPK mini IV, mettono
le manopole su una seconda porta).

### Preset incluso: Akai MPK mini IV (mk4)
Già mappato e pronto:
- **Manopole 1–4** → Encoder 1–4 (sono encoder *relativi*, CC 24–27)
- **Pad 1–4** → premono gli encoder 1–4
- **Pad 5–8** → navigazione griglia (X± / Y±)
- **Tastiera** → suona il campione del canale selezionato (vedi §7)

### Configurazione: `midi-map.txt`
Alla prima esecuzione viene creato `midi-map.txt` accanto all'eseguibile. È un file
di testo, modificabile, riletto al riavvio:

```
knobs=24,25,26,27        # i 4 CC delle manopole -> encoder 1..4
knobmode=relative        # 'relative' (encoder mk4) oppure 'absolute' (potenziometri mk3/Plus: 70..73)
pads=36,37,38,39,40,41,42,43   # le 8 note dei pad
notevelocity=110         # velocity fissa per note/pad che suonano un campione (0 = dinamica reale)
monitor=1                # registra il MIDI in arrivo su console + midi-log.txt
```

> **Non sai i numeri del tuo controller?** Lascia `monitor=1`, avvia l'emulatore,
> muovi manopole e premi i pad: ogni messaggio compare in console e in
> **`midi-log.txt`**. Copia i numeri giusti nel file e riavvia.

Per **altre MPK mini** (mk2/mk3/Plus) con manopole a potenziometro:
```
knobs=70,71,72,73
knobmode=absolute
```

---

## 7. Suonare i campioni con la tastiera MIDI

Lo strumento suona **il campione del canale attualmente selezionato** (la riga su
cui si trova il cursore, `SMP.y`):

1. **Seleziona il canale**: porta il cursore sulla riga del campione che vuoi
   suonare (con gli encoder, come sull'hardware).
2. **Suona la tastiera MIDI**: il **DO centrale (nota 60)** è l'intonazione base del
   campione; i tasti più alti/bassi lo **traspongono** di semitoni.
3. Suona un canale per volta (quello selezionato). Per suonare un altro suono,
   sposta il cursore su un'altra riga.

Se il sequencer è in **play**, le note suonate vengono anche **registrate** nello
step corrente (come sull'hardware).

### I pad come pulsanti (velocity disattivata)
Per impostazione predefinita **la velocity è fissa** (`notevelocity=110`): qualunque
nota/pad suona il campione sempre allo stesso volume — i pad si comportano da
**pulsanti**, non sono sensibili alla dinamica. Per riattivare la dinamica reale
metti `notevelocity=0` in `midi-map.txt`.

---

## 8. La demo (`--demo`)

`ni404emu.exe --demo` fa partire un brano di **4 pagine (64 step) in loop** che mostra
tutte le potenzialità:

- progressione di accordi **Am – F – C – G** (una per pagina);
- arrangiamento che cresce: intro → groove → apice → fill di chiusura;
- **8 campioni** ritmici/percussivi + **2 voci sintetizzate** (basso sawtooth e lead
  triangolare) con vere melodie;
- **pitch dei campioni per riga**, **filtro per-canale** udibile, **dinamica di
  velocity**, a **122 BPM**.

Premi **Esc** per uscire.

---

## 9. SD card e campioni

I campioni vivono in **`sdcard/`**, che fa da scheda SD virtuale, con la struttura
attesa dal firmware:

```
sdcard/
  0/ 1/ 2/ 3/ ...        # cartelle/pacchetti
  3/_300.wav .. _311.wav # il kit della demo (16-bit mono 44.1 kHz)
  autosaved.txt          # pattern salvato automaticamente
  settings.txt           # impostazioni dell'emulatore
```

- I file sono WAV **16-bit mono 44.1 kHz** con header standard.
- Puoi gestire/creare la struttura con **`wavmaker`** (in `sdcard/`).
- Il kit della demo è generato da `emulator/scripts/gen_samples.cpp`.

### Importare campioni (WAV / MP3 / FLAC)
**Trascina un file audio nella finestra**: l'emulatore lo **decodifica** (WAV, MP3 o
FLAC — decoder `dr_libs` integrati, nessuna dipendenza esterna), lo ricampiona a
**44.1 kHz mono 16-bit** e lo installa sulla SD (cartella `9/`, primo numero libero),
caricandolo nel canale corrente. I formati non supportati vengono rifiutati con un
messaggio. *(ogg/aiff non ancora supportati.)*

### Gestire la SD dal menu (TAB)
- **Cartella SD** → Invio: apre la cartella SD in Esplora file (gestisci i file a mano).
- **Cambiare cartella SD**: **trascina una cartella** sulla finestra → diventa la SD
  (i campioni vengono ricaricati). **Ripristina SD** → Invio per tornare alla predefinita.
- **Campioni SD** → Invio: **browser** che elenca tutti i `_N.wav` sulla SD (ordinati);
  **↑/↓** per scorrere, **Invio** carica il campione nel **canale corrente**,
  **Esc/TAB** esce.

### Registrazione (REC)
Tieni premuto **REC** per registrare dall'**ingresso audio selezionato** (menu TAB →
Ingresso audio; se nessuno è scelto usa l'ingresso predefinito del sistema) nel
**canale corrente**. Parte con un **count-in di 4 beat** a tempo di BPM (sulla griglia
appaiono **4-3-2-1**, come l'ON1 di TŒRN), poi registra (OLED **\*REC\***); **rilascia**
per fermare. La registrazione diventa subito suonabile **e viene salvata su SD**. È portabile: sul Teensy reale usa `AudioInputI2S`+`AudioRecordQueue`
(ingresso del codec SGTL5000), nell'emulatore cattura dal device d'ingresso.
**La registrazione viene salvata su SD** come `samples/9/_9NN.wav` (primo numero
libero) e caricata sul canale, così **persiste** dopo il riavvio (ed è richiamabile
dal browser campioni / dal salvataggio del brano).

> **Nota sui salvataggi:** all'avvio il firmware ricarica `autosaved.txt`. Un file di
> salvataggio vecchio o corrotto con valori di filtro a 0 chiuderebbe i filtri (audio
> quasi muto): il firmware ora **sanifica** i valori fuori range (filtri riaperti).
> I file di runtime (`autosaved.txt`, `settings.txt`, `eeprom.bin`, `midi-*.txt`) sono
> ignorati da git.

---

## 10. Compilare dai sorgenti

L'emulatore **ricompila il sorgente** del firmware (non esegue il `.hex`): servono il
codice e il toolchain.

### Windows (MSYS2 + MinGW)
```powershell
cd emulator\scripts
.\bootstrap-windows.ps1     # installa toolchain + SDL2 (una volta)
.\build.ps1                 # configura, compila, copia le DLL accanto all'exe
.\run.ps1                   # avvia
```
Build manuale:
```powershell
$env:PATH="C:\msys64\mingw64\bin;$env:PATH"
cmake -S emulator -B emulator/build -G "MinGW Makefiles" -DCMAKE_BUILD_TYPE=Release
cmake --build emulator/build
```

> Di default si compila **solo `ichosynth` (`ni404emu`)**. Per compilare anche il
> riferimento **TŒRN** clona il sorgente e attiva l'opzione:
> ```
> git clone --depth 1 https://github.com/soundpauli/toern.git emulator/toern-src
> cmake -S emulator -B emulator/build -DEMU_BUILD_TOERN_REF=ON
> cmake --build emulator/build
> ```

### macOS (Homebrew + clang)
```bash
cd emulator/scripts
./bootstrap-macos.sh        # installa Xcode CLT + cmake + sdl2 (una volta)
./build.sh                  # configura e compila ni404emu (+ toernemu)
./build/ni404emu            # avvia
```
Il `CMakeLists.txt` è già multipiattaforma: su macOS collega i framework **CoreMIDI**
/ **CoreFoundation**; su Windows usa **winmm** e linka staticamente il runtime MinGW.

### Verifiche headless (senza finestra)
```
ni404emu --selftest    # boot + loop + audio + LED + MIDI di prova
ni404emu --verify      # carica i WAV dalla SD e prova gli 8 canali
ni404emu --demotest    # renderizza l'intero loop della demo e riporta picco/clipping
```

---

## 11. Risoluzione problemi

| Sintomo | Causa / Rimedio |
|---|---|
| Audio troppo basso | Alza **Master volume** (TAB) o il volume interno; controlla che `autosaved.txt` non sia un salvataggio strano. |
| I tasti non fanno nulla | Clicca sulla **finestra grafica** per darle il focus (non sulla console). |
| Le manopole MIDI non rispondono | Controllo collegato prima dell'avvio; verifica `midi-map.txt` (CC e `knobmode`); guarda `midi-log.txt`. |
| Pad sensibili al tocco | È previsto disattivarlo: `notevelocity=110` (pulsanti). Per la dinamica: `notevelocity=0`. |
| L'exe non parte (Windows) | Tieni `SDL2.dll` accanto all'eseguibile (nello snapshot c'è già). |
| Display capovolto | Già corretto: la griglia rispecchia il pannello fisico (riga 1 in basso). |

---

## 12. Limiti noti

- È un **ricompilatore sorgente**, non un emulatore di CPU/binario: serve il codice
  del firmware, non il `.hex`.
- Fedeltà DSP **molto vicina ma non campione-per-campione** identica all'hardware
  (filtro SVF, inviluppi, freeverb, voce di resampling sono reimplementazioni).
- Non è cycle-accurate (timing guidato dal callback audio + loop).
- La **registrazione** funziona (cattura dall'ingresso → campione sul canale); resta
  in RAM (salvataggio su SD da fare). Il **granular** di TŒRN è ancora uno stub.
- Un firmware nuovo della stessa famiglia hardware può richiedere di estendere gli
  shim in `compat/` per le API che usa.

---

*Per dettagli di progetto e stato avanzamento: `emulator/STATUS.md` e
`emulator/STATUS-toern.md`.*
