luigismith/ichosynth/docs/manuals/DEV_ENVIRONMENT.md

[🇮🇹 Italiano](MANUALE_AMBIENTE.md) · **🇬🇧 English**

<div align="center">

# 💻 ichosynth — Development Environment

### Complete, up-to-date guide for Windows and macOS

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

</div>

> ⚡ **In a hurry?** ichosynth runs the real **TŒRN** firmware, and one command builds it for our hardware:
> `python firmware/build_toern.py`. Jump to [chapter 3](#3--the-fast-track-one-command-builds-it-all). The
> rest of the guide explains every step and prerequisite.

---

## 📑 Table of Contents

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

---

## 1 · What we install

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

| Component | Version | What it's for | Required |
|---|---|---|---|
| **arduino-cli** | latest | the command-line build toolchain | ✅ |
| **teensy:avr core** | **≥ 1.61.0** | the Teensy compiler + Teensy Loader | ✅ |
| **Python** | 3.x | runs `firmware/build_toern.py` (the build script) | ✅ |
| **Git** | latest | the script clones the TŒRN sources on first run | ✅ |
| **Custom drivers** | in the repo | `i2cEncoderLibV2`, `FastTouch`, `IchosOled` — already in `firmware/libraries/` | ✅ (bundled) |
| **GitHub CLI** | latest | optional, for version-controlling the project | optional |

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

---

## 2 · Requirements

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

---

## 3 · The fast track: one command builds it all

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

```bash
python firmware/build_toern.py
```

This produces the firmware at **`firmware/build/toern.hex`**. To build *and* flash in one go (if
`teensy_loader_cli` is on your PATH):

```bash
python firmware/build_toern.py --flash
```

Useful flags:

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

> 💡 The **first** build is slow (the Teensy core is compiled once) and it also **clones the TŒRN sources**
> into `emulator/toern-src/` if they aren't there yet. Later builds are fast.
>
> 🖱️ Just want to flash a **prebuilt** `.hex`? There's a one-click GUI flasher in **`tools/flasher/`** — see
> [chapter 8.3](#83-flashing-the-firmware).

---

## 4 · Installing the toolchain (arduino-cli)

We build from the command line with **[`arduino-cli`](https://arduino.github.io/arduino-cli/)**.

### Windows
```powershell
winget install ArduinoSA.CLI
```

### macOS
```bash
brew install arduino-cli
```

Check it's on your PATH:
```bash
arduino-cli version
```

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

---

## 5 · Adding Teensy support (the teensy:avr core)

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

```bash
arduino-cli config init
arduino-cli config add board_manager.additional_urls https://www.pjrc.com/teensy/package_teensy_index.json
arduino-cli core update-index
arduino-cli core install teensy:avr
```

Check the version you got:
```bash
arduino-cli core list
```
You should see `teensy:avr` at **1.61.0** or newer.

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

---

## 6 · The libraries

The TŒRN firmware compiles against three **custom drivers** that adapt it to our cheap hardware. They are
**already in the repo** under `firmware/libraries/`, and the build script points `arduino-cli` at them
automatically — you don't install them:

| Library | Replaces | Where the hardware config lives |
|---|---|---|
| **i2cEncoderLibV2** | TŒRN's 4 I²C RGB encoders → our 4 KY-040 mechanical encoders | `ICHOS_ENC_PINS` in `i2cEncoderLibV2.h` |
| **FastTouch** | TŒRN's 3 capacitive touch pads → our 3 momentary tact switches | `ICHOS_BTN_PINS` in `FastTouch.h` |
| **IchosOled** | adds the I²C **OLED HUD** (the state TŒRN showed on the encoder RGB rings) | `firmware/libraries/IchosOled/` |

> 🧭 **Where the hardware lives:** pin assignments live in those two headers (`ICHOS_ENC_PINS`,
> `ICHOS_BTN_PINS`) and in `firmware/build_toern.py` — **not** in a `config.h`. (`config.h` belongs to the old
> NI404 fallback build and is not used by the TŒRN port.)

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

---

## 7 · How the build script works

`firmware/build_toern.py` compiles the **unmodified** TŒRN sketch, applying only the minimal changes that make it
run on our hardware. Step by step:

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

The exact target it builds for is:

```text
teensy:avr:teensy41:usb=serialmidi16,opt=o1std
```

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

---

## 8 · Building and uploading

### 8.1 Build
From the repo root:
```bash
python firmware/build_toern.py
```
When it finishes you'll have **`firmware/build/toern.hex`**.

### 8.2 Build and flash in one step
If you have `teensy_loader_cli` on your PATH:
```bash
python firmware/build_toern.py --flash
```
1. Connect the Teensy 4.1 via USB (a **data** cable).
2. The loader usually programs on its own; if it stays waiting, press the **little white button** on the Teensy.
3. When the flash finishes, the animation starts on the LED matrix.

### 8.3 Flashing the firmware
If you'd rather flash a **prebuilt** `.hex` (or don't have `teensy_loader_cli`), use the **one-click GUI
flasher** in **`tools/flasher/`** — point it at `firmware/build/toern.hex` and click flash.

---

## 9 · Building from the Arduino IDE (alternative)

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

You'll also have to apply the pin remap (`SWITCH_1/2/3` → 25/26/28), make the three custom libraries in
`firmware/libraries/` visible to the IDE, and wire in the OLED HUD by hand. **The script does all of this for
you**, which is why it's the recommended path.

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

---

## 10 · Optional tools (Python, Git)

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

**Windows:** `winget install Python.Python.3.12`  · **macOS:** `brew install python@3.12`

> ℹ️ Any modern Python 3 works for the build script. (If you also use the `wavmaker` sample converter and run
> it from source on **Python 3.13+**, that one needs `pip install audioop-lts`, because `audioop` was removed
> from the standard library — but the ready-made `wavmaker.exe` in `sdcard/` needs no Python at all.)

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

---

## 11 · Checklist and common problems

| ✓ | Check |
|---|---|
| ☐ | `arduino-cli version` works (it's on your PATH) |
| ☐ | `arduino-cli core list` shows **teensy:avr ≥ 1.61.0** |
| ☐ | **Python 3** and **Git** are installed |
| ☐ | `python firmware/build_toern.py` produces `firmware/build/toern.hex` |
| ☐ | (IDE build only) USB Type = Serial + MIDIx16 **and** Optimize = "Fast" |
| ☐ | Teensy 4.1 has **16 MB PSRAM** soldered |

| Symptom | Cause / fix |
|---|---|
| `arduino-cli not on PATH …` from the script | install arduino-cli (ch. 4) and reopen the terminal |
| Compile dies with `exit 0xffffffff` / internal compiler error | you built at `-O2`; use the script, or set IDE Optimize → "Fast" (`-O1`) |
| `teensy:avr` missing / too old | run `arduino-cli core install teensy:avr` and check `core list` (need ≥ 1.61.0) |
| Script can't clone the TŒRN sources | install Git, or clone manually into `emulator/toern-src/` |
| `'usbMIDI' was not declared` (IDE build) | USB Type not set to Serial + MIDIx16 |
| `teensy_loader_cli not found` on `--flash` | use the GUI flasher in `tools/flasher/` instead |
| Teensy not programming | press the **white button** on the board; or use a **data** USB cable, not charge-only |
| Port not visible | charge-only USB cable → use a data cable |

---

<div align="center">

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

</div>
