luigismith/ichosynth/docs/manuals/MANUALE_AMBIENTE.md

**🇮🇹 Italiano** · [🇬🇧 English](DEV_ENVIRONMENT.md)

<div align="center">

# 💻 ichosynth — Ambiente di sviluppo

### Guida completa e aggiornata per Windows e macOS

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

</div>

> ⚡ **Hai fretta?** ichosynth esegue il firmware reale **TŒRN**, e un solo comando lo compila per il nostro
> hardware: `python firmware/build_toern.py`. Vai al [capitolo 3](#3--via-rapida-un-comando-compila-tutto). Il
> resto della guida spiega ogni passo e prerequisito.

---

## 📑 Indice

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

---

## 1 · Cosa installiamo

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

| Componente | Versione | A cosa serve | Obbligatorio |
|---|---|---|---|
| **arduino-cli** | ultima | la toolchain di build da riga di comando | ✅ |
| **core teensy:avr** | **≥ 1.61.0** | il compilatore Teensy + il Teensy Loader | ✅ |
| **Python** | 3.x | esegue `firmware/build_toern.py` (lo script di build) | ✅ |
| **Git** | ultima | lo script clona i sorgenti TŒRN alla prima esecuzione | ✅ |
| **Driver personalizzati** | nel repo | `i2cEncoderLibV2`, `FastTouch`, `IchosOled` — già in `firmware/libraries/` | ✅ (inclusi) |
| **GitHub CLI** | ultima | opzionale, per versionare il progetto | opzionale |

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

---

## 2 · Requisiti

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

---

## 3 · Via rapida: un comando compila tutto

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

```bash
python firmware/build_toern.py
```

Questo produce il firmware in **`firmware/build/toern.hex`**. Per compilare *e* flashare in un colpo solo (se
`teensy_loader_cli` è nel tuo PATH):

```bash
python firmware/build_toern.py --flash
```

Flag utili:

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

> 💡 La **prima** compilazione è lenta (il core Teensy viene compilato una volta) e inoltre **clona i sorgenti
> TŒRN** in `emulator/toern-src/` se non ci sono ancora. Le compilazioni successive sono rapide.
>
> 🖱️ Vuoi solo flashare un `.hex` **già pronto**? C'è un flasher GUI a un clic in **`tools/flasher/`** — vedi il
> [capitolo 8.3](#83-flashare-il-firmware).

---

## 4 · Installare la toolchain (arduino-cli)

Compiliamo da riga di comando con **[`arduino-cli`](https://arduino.github.io/arduino-cli/)**.

### Windows
```powershell
winget install ArduinoSA.CLI
```

### macOS
```bash
brew install arduino-cli
```

Verifica che sia nel PATH:
```bash
arduino-cli version
```

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

---

## 5 · Aggiungere il supporto Teensy (il core teensy:avr)

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

```bash
arduino-cli config init
arduino-cli config add board_manager.additional_urls https://www.pjrc.com/teensy/package_teensy_index.json
arduino-cli core update-index
arduino-cli core install teensy:avr
```

Controlla la versione che hai ottenuto:
```bash
arduino-cli core list
```
Dovresti vedere `teensy:avr` alla **1.61.0** o successiva.

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

---

## 6 · Le librerie

Il firmware TŒRN si compila contro tre **driver personalizzati** che lo adattano al nostro hardware economico.
Sono **già nel repo** sotto `firmware/libraries/`, e lo script di build li indica ad `arduino-cli`
automaticamente — non devi installarli:

| Libreria | Sostituisce | Dove sta la configurazione hardware |
|---|---|---|
| **i2cEncoderLibV2** | i 4 encoder RGB I²C di TŒRN → i nostri 4 encoder meccanici KY-040 | `ICHOS_ENC_PINS` in `i2cEncoderLibV2.h` |
| **FastTouch** | i 3 pad capacitivi di TŒRN → i nostri 3 pulsanti tattili momentanei | `ICHOS_BTN_PINS` in `FastTouch.h` |
| **IchosOled** | aggiunge l'**HUD OLED** I²C (lo stato che TŒRN mostrava sugli anelli RGB degli encoder) | `firmware/libraries/IchosOled/` |

> 🧭 **Dove vive l'hardware:** l'assegnazione dei pin sta in quei due header (`ICHOS_ENC_PINS`,
> `ICHOS_BTN_PINS`) e in `firmware/build_toern.py` — **non** in un `config.h`. (`config.h` appartiene alla vecchia
> build di fallback NI404 e non viene usato dal port TŒRN.)

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

---

## 7 · Come funziona lo script di build

`firmware/build_toern.py` compila lo sketch TŒRN **non modificato**, applicando solo le modifiche minime che lo
fanno girare sul nostro hardware. Passo per passo:

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

Il target esatto per cui compila è:

```text
teensy:avr:teensy41:usb=serialmidi16,opt=o1std
```

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

---

## 8 · Compilare e caricare

### 8.1 Compilare
Dalla radice del repo:
```bash
python firmware/build_toern.py
```
Al termine avrai **`firmware/build/toern.hex`**.

### 8.2 Compilare e flashare in un passo
Se hai `teensy_loader_cli` nel PATH:
```bash
python firmware/build_toern.py --flash
```
1. Collega il Teensy 4.1 via USB (cavo **dati**).
2. Il loader di solito programma da solo; se resta in attesa, premi il **pulsantino bianco** sul Teensy.
3. A fine flash parte l'animazione sulla matrice LED.

### 8.3 Flashare il firmware
Se preferisci flashare un `.hex` **già pronto** (o non hai `teensy_loader_cli`), usa il **flasher GUI a un
clic** in **`tools/flasher/`** — puntalo a `firmware/build/toern.hex` e clicca flash.

---

## 9 · Compilare dall'Arduino IDE (alternativa)

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

Dovrai inoltre applicare il remap dei pin (`SWITCH_1/2/3` → 25/26/28), rendere visibili all'IDE le tre librerie
personalizzate in `firmware/libraries/` e cablare a mano l'HUD OLED. **Lo script fa tutto questo per te**, ed è
per questo che è il percorso consigliato.

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

---

## 10 · Strumenti opzionali (Python, Git)

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

**Windows:** `winget install Python.Python.3.12`  · **macOS:** `brew install python@3.12`

> ℹ️ Per lo script di build va bene qualsiasi Python 3 moderno. (Se usi anche il convertitore di campioni
> `wavmaker` e lo esegui dai sorgenti su **Python 3.13+**, quello richiede `pip install audioop-lts`, perché
> `audioop` è stato rimosso dalla libreria standard — ma il `wavmaker.exe` pronto in `sdcard/` non richiede
> Python.)

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

---

## 11 · Checklist e problemi comuni

| ✓ | Controllo |
|---|---|
| ☐ | `arduino-cli version` funziona (è nel PATH) |
| ☐ | `arduino-cli core list` mostra **teensy:avr ≥ 1.61.0** |
| ☐ | **Python 3** e **Git** sono installati |
| ☐ | `python firmware/build_toern.py` produce `firmware/build/toern.hex` |
| ☐ | (solo build da IDE) USB Type = Serial + MIDIx16 **e** Optimize = "Fast" |
| ☐ | Il Teensy 4.1 ha **16 MB di PSRAM** saldati |

| Sintomo | Causa / soluzione |
|---|---|
| `arduino-cli not on PATH …` dallo script | installa arduino-cli (cap. 4) e riapri il terminale |
| La compilazione muore con `exit 0xffffffff` / internal compiler error | hai compilato a `-O2`; usa lo script, oppure imposta Optimize → "Fast" (`-O1`) nell'IDE |
| `teensy:avr` mancante / troppo vecchio | esegui `arduino-cli core install teensy:avr` e controlla `core list` (serve ≥ 1.61.0) |
| Lo script non riesce a clonare i sorgenti TŒRN | installa Git, oppure clona a mano in `emulator/toern-src/` |
| `'usbMIDI' was not declared` (build da IDE) | USB Type non su Serial + MIDIx16 |
| `teensy_loader_cli not found` con `--flash` | usa invece il flasher GUI in `tools/flasher/` |
| Il Teensy non si programma | premi il **pulsante bianco** sulla scheda; oppure usa un cavo USB **dati**, non solo-carica |
| Porta non visibile | cavo USB solo-carica → usa un cavo dati |

---

<div align="center">

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

</div>
