luigismith/ichosynth/docs/manuals/MANUALE_COSTRUZIONE.md

**🇮🇹 Italiano** · [🇬🇧 English](BUILD_MANUAL.md)

<div align="center">

ichosynth: matrice LED 16×16 accesa dietro il diffusore, pannello con OLED, 4 manopole e 3 tasti

# 🔧 ichosynth — Manuale di costruzione

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

</div>

> 📄 **Le guide grafiche** (stampabili, quasi senza testo):
> **[Cablaggio](../wiring/CABLAGGIO.pdf)** — 7 tavole, un filo alla volta ·
> **[Montaggio del case 3D](../../case/MONTAGGIO.pdf)** — 18 pagine ·
> **[Quick-start da banco](../workshop/QUICKSTART_COSTRUZIONE.md)** — la checklist.
> Questo manuale spiega il perché di ogni passo e tiene le tabelle di riferimento.

## In breve

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

## 📑 Indice

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

---

## 1 · Cosa ti serve

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

| Q.tà | Componente | Note |
|---|---|---|
| 1 | **Teensy 4.1** | il microcontrollore |
| 2 | Chip **PSRAM 8 MB** (APS6404) | **entrambi obbligatori** (16 MB): TŒRN usa ~16,5 MB di memoria esterna |
| 1 | **Teensy Audio Adaptor Rev D** (per Teensy 4.x) | codec SGTL5000 + jack cuffie 3,5 mm |
| 1 | Matrice LED **WS2812B 16×16** (256 LED) | rigida o flessibile (160 mm) |
| **4** | Encoder **KY-040** con pulsante | E1 … E4 |
| **3** | Tact switch **6×6 mm** | PLAY · MENU · REC — **alti 4,3 mm** se usi il case |
| 1 | OLED **SSD1306 0,96" 128×64 I²C** | sostituisce gli anelli colorati degli encoder |
| 1 | Jack **mono TS 6,35 mm** da pannello | LINE IN, per registrare (l'uscita è il jack cuffie della scheda audio) |
| 1 | Micro SD **Class 10**, ≤ 32 GB, FAT32 | campioni e pattern |
| 1 | Cavo micro-USB **dati** + alimentatore 5 V ≥ 2 A | alimentazione e programmazione |
| 1 | Cuffie con jack 3,5 mm | niente altoparlanti a bordo |
| 2 | Strisce di **header maschi lunghi** (≥ 15 mm, 14 pin) | per impilare la scheda audio sul Teensy |
| 2 | *(consigliati)* **Morsetti a leva** 5 poli (es. WAGO 221-415) | barre 3,3 V e GND senza saldare |
| q.b. | Filo AWG 26 in 6+ colori | ~20 fili da 10-15 cm |
| 1 | *(facoltativo)* **Case stampato 3D** | [`case/`](../../case/) — 3 pezzi, 2 piatti 250×250 |

> ℹ️ **Campioni**: il set di fabbrica in `sdcard/` è **public domain** (raccolta *drum_sklad*),
> ridistribuibile liberamente. Puoi aggiungere i tuoi (vedi [cap. 7](#7--prepara-la-micro-sd)).

---

## 2 · Difficoltà, strumenti, sicurezza

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

> ⏱️ Tempo: mezza giornata per chi sa già saldare (PSRAM esclusa).

---

## 3 · Prepara il Teensy e la scheda audio

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

**3.2 · Impila la scheda audio**

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

---

## 4 · Cablaggio

> 🎨 Versione tutta illustrata, da tenere sul banco: **[`docs/wiring/CABLAGGIO.pdf`](../wiring/CABLAGGIO.pdf)**.
> I numeri dei pin lì e qui sono quelli dei driver del firmware (`ICHOS_ENC_PINS`, `ICHOS_BTN_PINS`
> in `firmware/libraries/`).

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

### 4.1 · Alimentazione: due morsetti

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

### 4.2 · Encoder KY-040 (×4)

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

### 4.3 · Tasti PLAY · MENU · REC

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

| Tasto | Pin Teensy | Altra gamba |
|---|---|---|
| **PLAY** | **25** | GND |
| **MENU** | **26** | GND |
| **REC** | **28** | GND |

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

</td></tr></table>

### 4.4 · OLED

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

| Pin OLED | Va a |
|---|---|
| **GND** | morsetto GND |
| **VCC** | morsetto 3V3 |
| **SCL** | pin **19** |
| **SDA** | pin **18** |

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

</td></tr></table>

### 4.5 · Matrice LED

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

</td></tr></table>

### 4.6 · Audio: LINE IN e cuffie

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

</td></tr></table>

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

### 4.7 · Controllo prima di accendere

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

---

## 5 · Case stampato 3D (opzionale)

<p align="center">Esploso del case: vasca, matrice, diffusore con griglia, pannello comandi con encoder, OLED e tasti</p>

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

<table><tr>
<td align="center"><br>piatto 1 · nero</td>
<td align="center"><br>piatto 2 · traslucido</td>
</tr></table>

Progetti pronti per **Anycubic Slicer Next** (Kobra S1 Combo + ACE Pro, slot 1 nero, slot 2
traslucido, cambio colore già impostato): `case/ichosynth_case_S1Combo.3mf` (tutto PLA) e
`case/ichosynth_case_S1Combo_PETG.3mf` (tutto PETG). **Mai PLA e PETG nello stesso pezzo**: non si
attaccano fra loro.

👉 Guida passo-passo: **[`case/MONTAGGIO.pdf`](../../case/MONTAGGIO.pdf)** · stampa e parametri:
[`case/README.md`](../../case/README.md). Con il case: encoder in 2×2, switch **alti 4,3 mm**, fili
saldati (niente Dupont), jack LINE IN con ingombro ≤ 22 × 16 mm dietro la parete.

---

## 6 · Carica il firmware

**Il modo più semplice — flasher a un clic (Windows):**
1. collega il Teensy via USB;
2. apri **`tools/flasher/flasher.exe`** (al primo avvio SmartScreen: *Ulteriori informazioni → Esegui comunque*);
3. premi **⚡ Flash ichosynth** e, quando te lo chiede, il pulsantino **PROGRAM** sul Teensy;
4. attendi *"Firmware scritto e Teensy riavviato"*.

Il flasher contiene già il firmware compilato (`tools/flasher/ichosynth.hex`) e controlla che il file
sia integro prima di scriverlo.

**Compilare dai sorgenti:**
```sh
python firmware/build_toern.py            # -> firmware/build/toern.hex
python firmware/build_toern.py --flash    # compila e flasha (teensy_loader_cli)
```
Serve `arduino-cli` con il core `teensy:avr` (≥ 1.61.0). Lo script prende i sorgenti TŒRN alla
versione verificata, adatta i pin ai nostri componenti, usa la FastLED del core Teensy e compila
a `-O1` (a `-O2` il compilatore va in crash sul file da ~23 000 righe di TŒRN). Dettagli e patch:
[`firmware/README.md`](../../firmware/README.md).

---

## 7 · Prepara la micro SD

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

Il modo più rapido: **copia il contenuto di [`sdcard/`](../../sdcard/) sulla radice** di una SD FAT32
(6 pack + libreria pronti).

**Aggiungere i tuoi campioni** — `tools/wavmaker/wavmaker.exe` (o `python tools/wavmaker/wavmaker_gui.py`):
1. scegli la **modalità**: *Samplepack* (8 voci → `<pack>/1-8.wav`, ordine con ↑ ↓) o *Libreria*;
2. **Aggiungi file/cartella**: le righe verdi sono già nel formato giusto;
3. **Scansiona** la SD (trova il prossimo pack libero) o scrivi in una cartella locale;
4. **Converti**. Gli originali restano, a meno che tu non scelga di eliminarli.

wavmaker formatta solo **schede SD removibili** e chiede conferma mostrando disco e partizioni.
Per rigenerare il set di fabbrica: `python tools/wavmaker/build_samples.py`.

---

## 8 · Primo avvio

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

> 🎮 Per suonarlo: **[Manuale d'Uso](MANUALE_USO.md)** e la mappa comandi
> [`docs/reference/MAPPA_CONTROLLI.md`](../reference/MAPPA_CONTROLLI.md).

---

## 9 · Se qualcosa non va

| Sintomo | Rimedio |
|---|---|
| 🔌 Il PC non lo riconosce | cavo USB **dati** (non solo-carica); corto 5 V–GND; saldature degli header |
| 🔁 Si riavvia da solo | PSRAM mancante o mal saldata (servono 2 chip); alimentatore ≥ 2 A |
| 💡 LED spenti o colori sbagliati | DIN non sul pin 17; connettore d'uscita invece che d'ingresso; GND non comune |
| ↩️ Un encoder gira al contrario | scambia **CLK e DT** di quell'encoder |
| ⏩ Un click fa due passi | imposta `ICHOS_ENC_COUNTS_PER_DETENT` a 2 nel driver e ricompila |
| 🔇 Encoder o tasto non risponde | pin sbagliato: confronta con la [mappa](#4--cablaggio); il tasto va pin → GND |
| 💾 Icona noSD | SD nello slot del **Teensy**, FAT32, ≤ 32 GB |
| 🎧 Nessun suono | scheda audio impilata male; volume a 0; jack cuffie della scheda audio |
| 🚫 Un canale è muto | WAV non mono/16 bit/44,1 kHz o percorso sbagliato: usa wavmaker |
| 📟 OLED nero | VCC/GND invertiti; SDA/SCL scambiati; indirizzo 0x3D |
| ❌ La build fallisce | `arduino-cli` + core `teensy:avr` installati? lancia `python firmware/build_toern.py` |

---

## 10 · Schema riassuntivo dei pin

```
Matrice LED   DIN 17 · 5V da VIN · GND
Encoder E1    CLK 5   DT 22  SW 15        Audio (impilata)  MCLK 23 · BCLK 21 · LRCLK 20
Encoder E2    CLK 32  DT 33  SW 41                          TX 7 · RX 8 · SDA 18 · SCL 19
Encoder E3    CLK 9   DT 14  SW 16        OLED              SDA 18 · SCL 19 · 3V3 · GND (0x3C)
Encoder E4    CLK 37  DT 38  SW 39        LINE IN           punta → LINE IN L · massa → GND
Tasti         PLAY 25 · MENU 26 · REC 28  (pin → GND)        MIDI DIN (opz.)   IN 34 · OUT 35
Da evitare    2 / 3 / 4 (interni TŒRN) · 24 · non montare il pot del volume (A1 = pin 15)
Alimentazione matrice 5 V (VIN) · encoder, OLED, audio 3,3 V · GND tutti insieme
```

---

<div align="center">

Buona costruzione! 🛠️ Quando suona, passa al **[Manuale d'Uso](MANUALE_USO.md)**.

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

</div>
