luigismith/ichosynth/case/MONTAGGIO.html

ichosynth

case stampato in 3D · guida di montaggio



3 pezzi2 piatti · Kobra S10 supporti239 × 179 mm · h 16 / 28 mm

ichosynth

Stampa

2



PIATTO 1PLA/PETG nerovasca + pannello



PIATTO 2PLA/PETG traslucidoZ 1.4 mm → nero

0,2 mm3 perimetri15 %niente supportitutto PLA o tutto PETG

ichosynth_case_S1Combo.3mf (PLA)ichosynth_case_S1Combo_PETG.3mf

ichosynth

Cosa serve

3



×1

matrice WS2812B 16×16



×1

Teensy 4.1 + Audio Rev D



×4

encoder KY-040



×1

OLED SSD1306 0,96"



×3

tact switch 6×6×4,3



×1

jack mono 6,35 (LINE IN)



×8

vite M3×8 svasata



×4

piedini Ø10

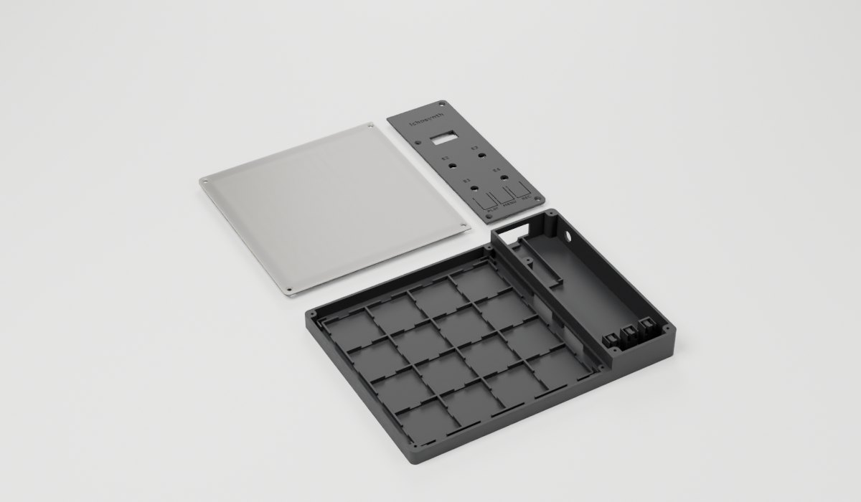
[picture p77: case/img/item_prints.jpg]


ichosynth

Montaggio

4

1

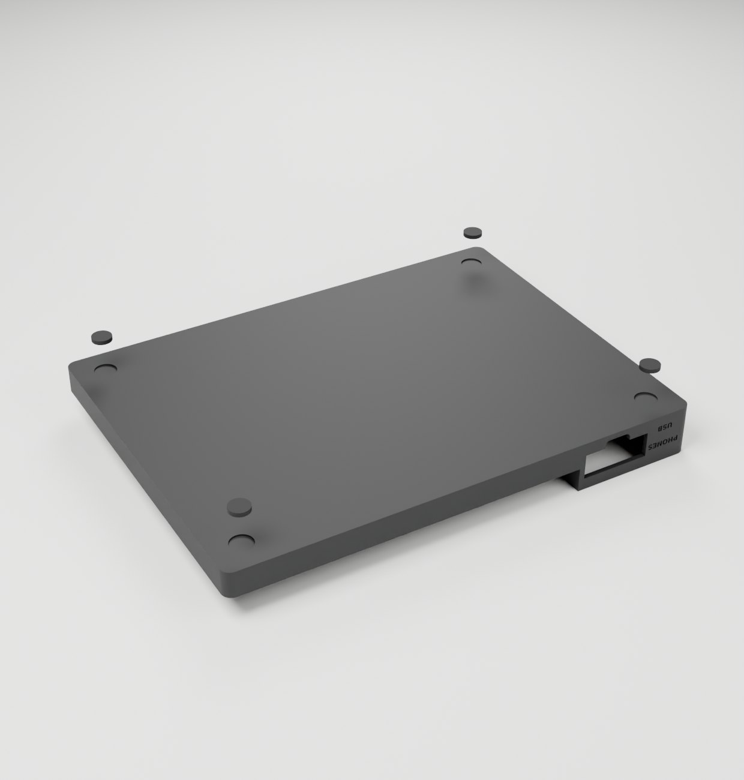
[picture p78: case/img/s01_feet.jpg]


×4piedini adesivi

2

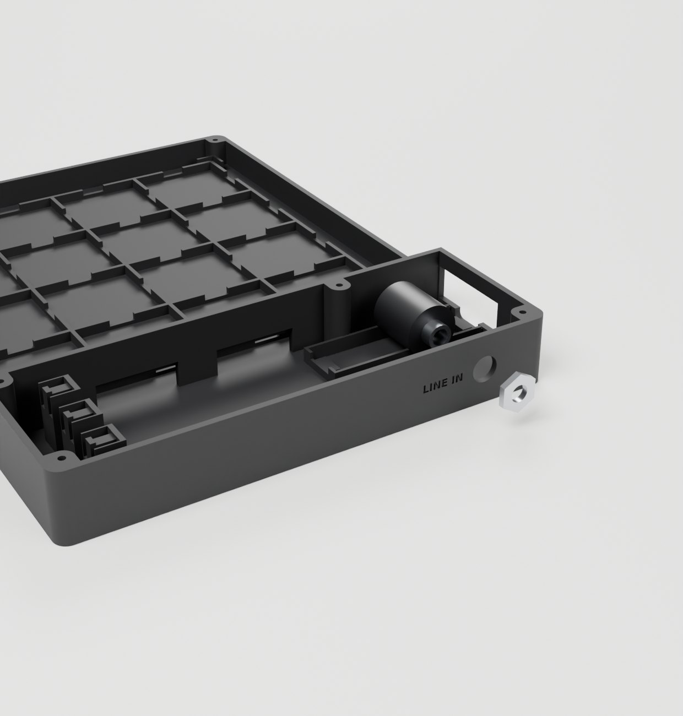
[picture p79: case/img/s02_jacks.jpg]


LINE INdado fuori≤ 22 × 16 mm

ichosynth

Montaggio

5

3

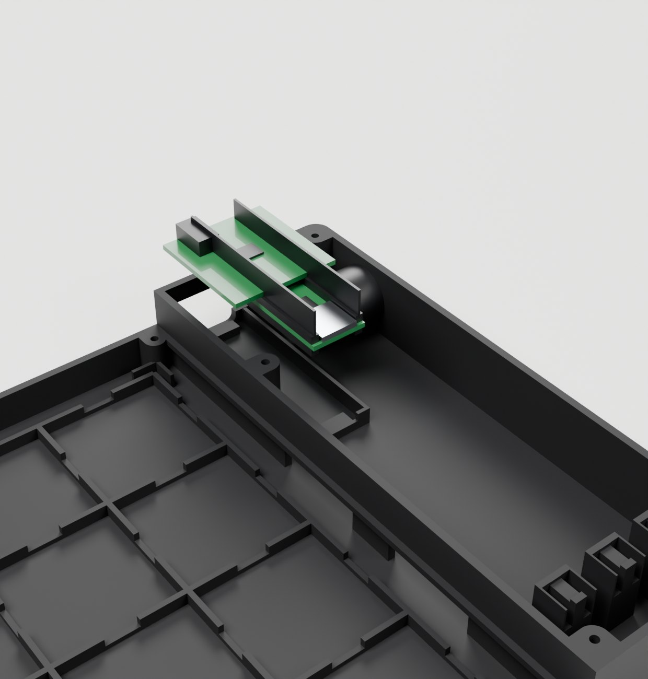
[picture p80: case/img/s03_teensy.jpg]


USB + PHONES dal retro

ichosynth

Cablaggio

6

4

cablaggio: le 7 tavole seguentianche in docs/wiring/CABLAGGIO.pdf

ichosynth

Cablaggio · cosa serve

7

Componenti

- Teensy 4.1 + scheda audio Rev Dil cervello e il suono
- 4 × encoder KY-040E1 · E2 · E3 · E4
- 3 × tact switch 6×6PLAY · MENU · REC
- OLED SSD1306 0,96" I²Cschermo di stato
- matrice WS2812B 16×16la griglia di LED
- 1 × jack mono 6,35 mmLINE IN (registrare)
- 2 × morsetti a leva (es. WAGO 221-415)barre 3V3 e GND, senza saldare
- 2 strisce di header maschi lunghi (≥ 15 mm)Teensy ↔ scheda audio
- filo AWG 26 in 6+ colori, stagno, saldatoreuna ventina di fili da 10-15 cm

Il quadro d'insieme

Colori dei fili

5V3,3 VGND (massa)E1E2E3E4pulsantiOLED (I²C)matriceLINE IN

Tre regole

⚠️ Tutte le masse (GND) insieme. Ogni modulo va al morsetto GND, e il morsetto al GND del Teensy.

⚠️ Encoder e OLED a 3,3 V, mai a 5 V. Solo la matrice LED va a 5 V (pin VIN).

ℹ️ Un filo alla volta: salda, controlla il numero del pin due volte, poi passa al prossimo.

ℹ️ Il colore dei fili è un consiglio: aiuta a non sbagliare. Gli encoder hanno il colore della loro manopola.

ichosynth

Cablaggio · il Teensy 4.1

8

Come leggere la mappa

ℹ️ Il Teensy è visto da sopra, con la presa USB in alto. I numeri sono quelli stampati sulla scheda e sul cartoncino che la accompagna.

ℹ️ I pin colorati sono quelli che usi; gli altri restano liberi.

ℹ️ La zona tratteggiata è coperta dalla scheda audio: quei pin si saldano sulle punte degli header lunghi, sopra la scheda audio (pagina seguente).

✅ Ci sono più pin GND e 3,3 V: usa quelli fuori dalla scheda audio (lato sinistro 15° = 3,3 V, lato destro 15° = GND) per i morsetti.

ichosynth

Cablaggio · scheda audio e alimentazione

9

1 · Impila la scheda audio

ℹ️ Salda 2 strisce da 14 header maschi lunghi sul Teensy (le prime 14 posizioni di ogni lato, dalla USB in giù), con la plastica appoggiata sul Teensy.

ℹ️ Infila la scheda audio con il jack cuffie dallo stesso lato della USB, spingila giù finché appoggia sulla plastica dell'header e saldala.

✅ Le punte che sporgono sopra la scheda audio sono i pin del Teensy: i fili dei pin sotto la scheda audio si saldano lì.

2 · Barre di alimentazione

Teensy 3.3Vmorsetto 3V3lato sinistro, 15° dall'alto

Teensy GNDmorsetto GNDlato destro, 15° dall'alto

ℹ️ Ai morsetti vanno poi il + e il GND dei 4 encoder e dell'OLED, e il GND dei pulsanti e del jack.

✅ Morsetti a leva: spellare 11 mm, alzare la leva, infilare, abbassare. Niente saldature.

ichosynth

Cablaggio · 4 encoder KY-040

10

Il modulo KY-040

ℹ️ Le scritte CLK DT SW + GND sono stampate sul modulo: leggi le tue, l'ordine può cambiare.

Dove sta ogni encoder

ℹ️ E1 ed E4 (cursore) in basso, vicino alla mano.

E1

E1 CLKpin 5lato sinistro, 7° dall'alto · sopra la scheda audio

E1 DTpin 22lato destro, 5° dall'alto · sopra la scheda audio

E1 SWpin 15lato destro, 12° dall'alto · sopra la scheda audio

E1 +morsetto 3V33,3 V, mai 5 V

E1 GNDmorsetto GND

E2

E2 CLKpin 32lato sinistro, 24° dall'alto

E2 DTpin 33lato destro, 24° dall'alto

E2 SWpin 41lato destro, 16° dall'alto

E2 +morsetto 3V33,3 V, mai 5 V

E2 GNDmorsetto GND

E3

E3 CLKpin 9lato sinistro, 11° dall'alto · sopra la scheda audio

E3 DTpin 14lato destro, 13° dall'alto · sopra la scheda audio

E3 SWpin 16lato destro, 11° dall'alto · sopra la scheda audio

E3 +morsetto 3V33,3 V, mai 5 V

E3 GNDmorsetto GND

E4

E4 CLKpin 37lato destro, 20° dall'alto

E4 DTpin 38lato destro, 19° dall'alto

E4 SWpin 39lato destro, 18° dall'alto

E4 +morsetto 3V33,3 V, mai 5 V

E4 GNDmorsetto GND

ℹ️ Se un encoder gira al contrario, scambia i fili CLK e DT di quell'encoder. Se un click fa due passi, vedi ICHOS_ENC_COUNTS_PER_DETENT nel driver.

ichosynth

Cablaggio · pulsanti e OLED

11

3 pulsanti

ℹ️ Usa due gambe in diagonale: così il contatto c'è sempre, in qualunque verso lo monti.

PLAY gambapin 25lato sinistro, 17° dall'alto

PLAY gamba oppostamorsetto GND

MENU gambapin 26lato sinistro, 18° dall'alto

MENU gamba oppostamorsetto GND

REC gambapin 28lato sinistro, 20° dall'alto

REC gamba oppostamorsetto GND

Schermo OLED

OLED GNDmorsetto GND

OLED VCCmorsetto 3V33,3 V

OLED SCLpin 19lato destro, 8° dall'alto · sopra la scheda audio

OLED SDApin 18lato destro, 9° dall'alto · sopra la scheda audio

⚠️ Su alcuni moduli VCC e GND sono invertiti: segui le scritte stampate sul tuo.

ℹ️ L'OLED condivide SDA/SCL con la scheda audio: è normale, hanno indirizzi diversi.

ichosynth

Cablaggio · matrice e audio

12

Matrice LED 16×16

matrice 5V (rosso)pin VINlato destro, 1° in alto · sopra la scheda audio

matrice GND (bianco)morsetto GND

matrice DIN (verde)pin 17lato destro, 10° dall'alto · sopra la scheda audio

⚠️ Usa il connettore dove la freccia entra nella matrice (DIN), non quello d'uscita (DOUT).

ℹ️ I colori dei fili della matrice variano fra i produttori: conta la scritta sul PCB (5V / GND / DIN).

LINE IN (per registrare)

ℹ️ Il pad LINE IN L è sulla scheda audio, vicino alle scritte LINE IN: c'è scritto sul PCB.

✅ Le cuffie si collegano al jack 3,5 mm della scheda audio: nessun filo da saldare.

⚠️ Non montare il potenziometro del volume sulla scheda audio: il suo pad (A1) è il pin 15, usato da E1.

ℹ️ MIDI DIN (facoltativo): pin 34 = IN, 35 = OUT, serve un circuito con optoisolatore.

ichosynth

Cablaggio · controllo finale

13

Prima di accendere

- Ogni filo del Teensy va al numero giusto: confronta con la mappa a pagina 2.
- Nessun filo va a 5 V tranne il rosso della matrice (pin VIN).
- Tutti i GND arrivano al morsetto GND, e il morsetto al GND del Teensy.
- Multimetro in continuità: nessun corto fra 5 V e GND e fra 3,3 V e GND.
- Nessuna goccia di stagno fra due pin vicini (guarda con una lente).
- Micro-SD nello slot del Teensy (in basso sulla scheda), non in quello della scheda audio.
- Poi collega la USB: la matrice si accende e l'OLED mostra CH / MODE / BPM.

Tutti i collegamenti

E1 CLK → pin 5E1 DT → pin 22E1 SW → pin 15E2 CLK → pin 32E2 DT → pin 33E2 SW → pin 41E3 CLK → pin 9E3 DT → pin 14E3 SW → pin 16E4 CLK → pin 37E4 DT → pin 38E4 SW → pin 39PLAY → pin 25MENU → pin 26REC → pin 28OLED SDA → pin 18OLED SCL → pin 19matrice DIN → pin 17matrice 5V → VINLINE IN → pad LINE IN L

Il quadro d'insieme

ichosynth

Montaggio

14

5

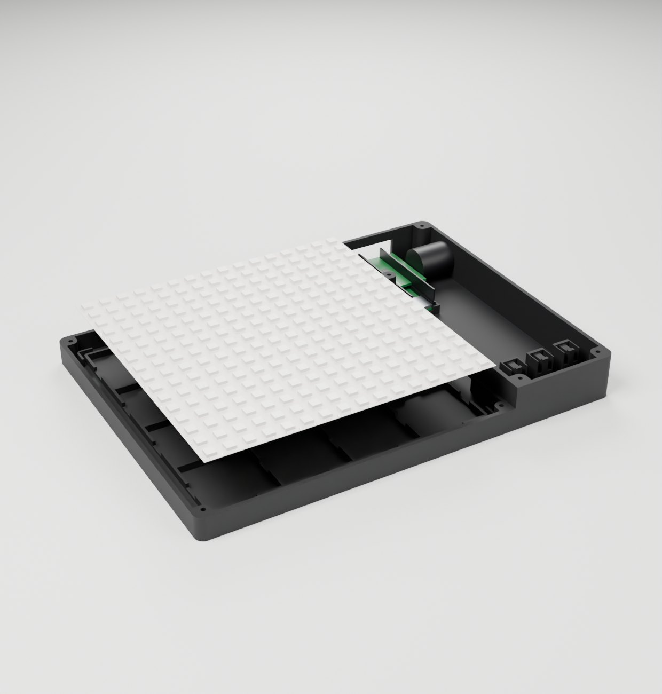
[picture p81: case/img/s05_matrix.jpg]


LED in altofili nelle tacche

6

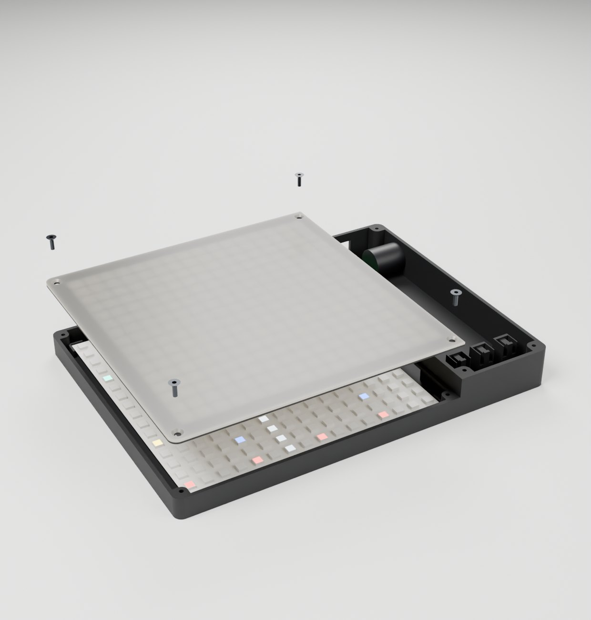
[picture p82: case/img/s06_window.jpg]


M3×8 ×4

ichosynth

Montaggio

15

7

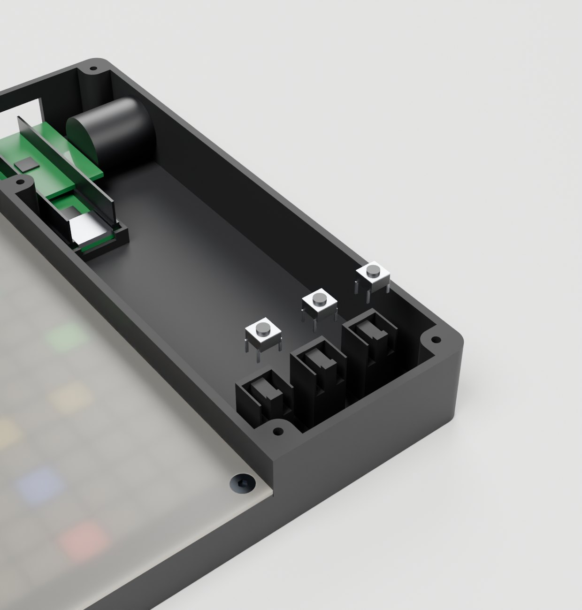
[picture p83: case/img/s07_switches.jpg]


2 gambe in diagonalefili saldati prima

8

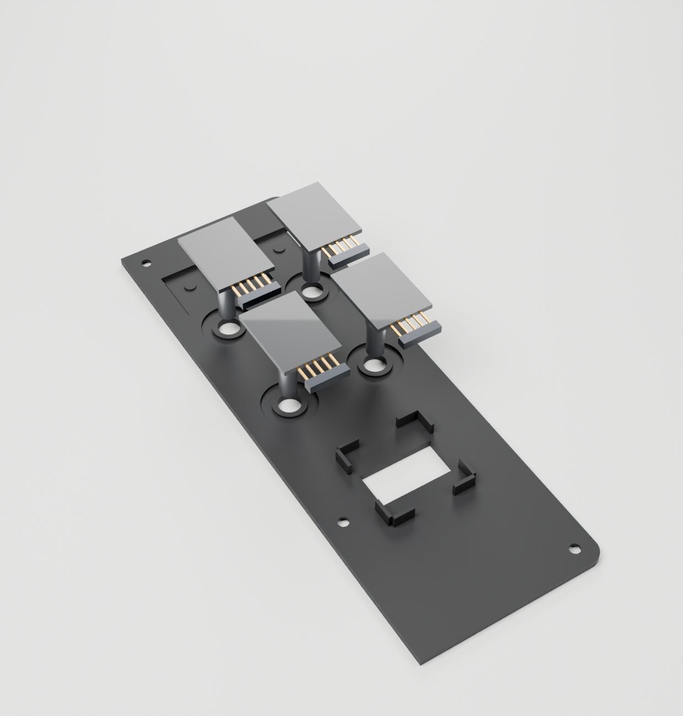
[picture p84: case/img/s08_encoders.jpg]


dado M7 soprapin verso il retrofili giù subito

ichosynth

Montaggio

16

9

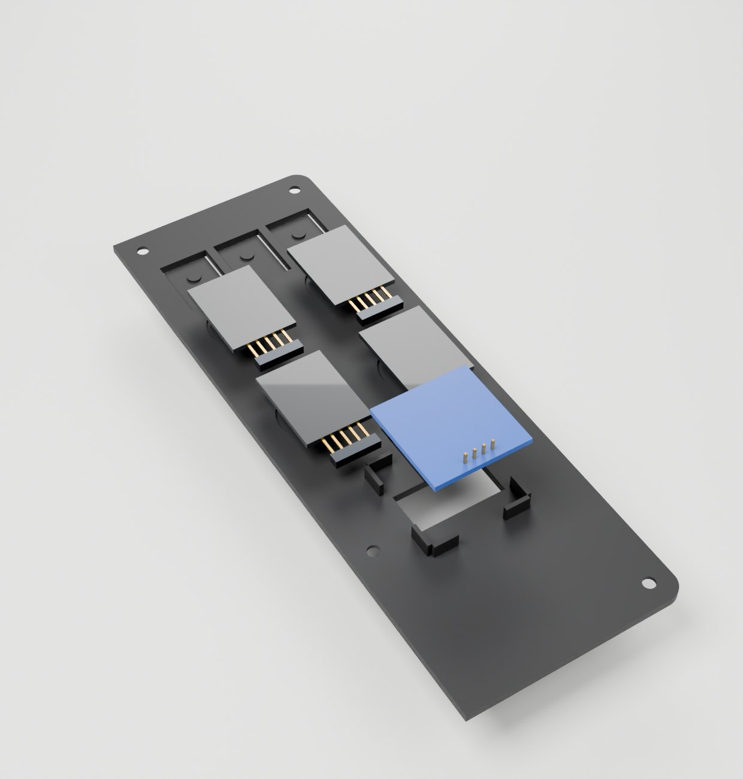
[picture p85: case/img/s09_oled.jpg]


vetro nella finestra

10



M3×8 ×4

ichosynth

Montaggio

17

11

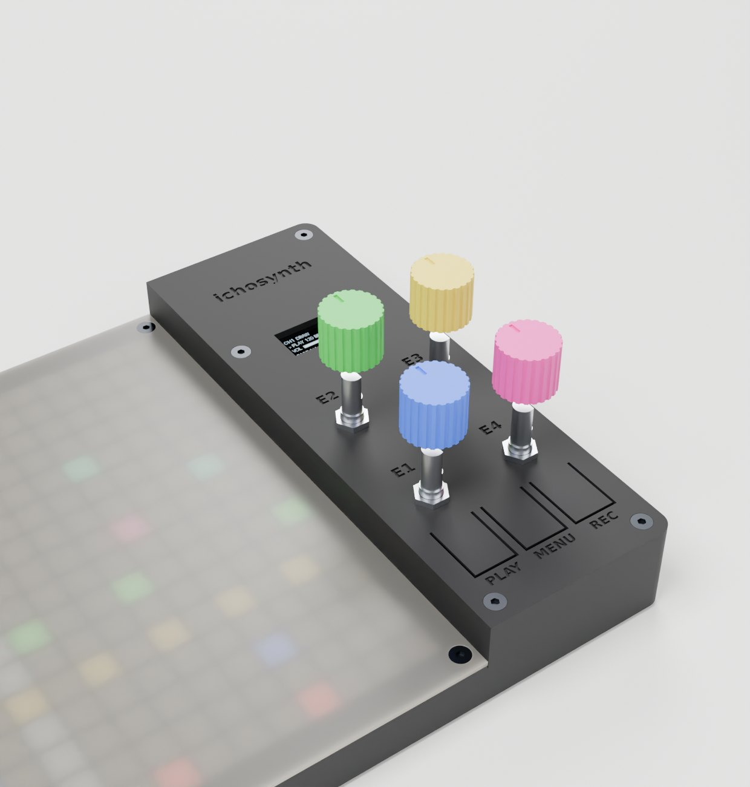
[picture p86: case/img/s11_knobs.jpg]


facoltativestl/knob.stl

ichosynth

Pronto

18





PLAY · MENU · RECE2 E3 / E1 E4micro-SD: togli il pannello
