luigismith/ichosynth/_DOCS/_PCB/ni404/ni404.kicad_pcb

## KiCad design _DOCS/_PCB/ni404/ni404.kicad_pcb (2026-05-21)

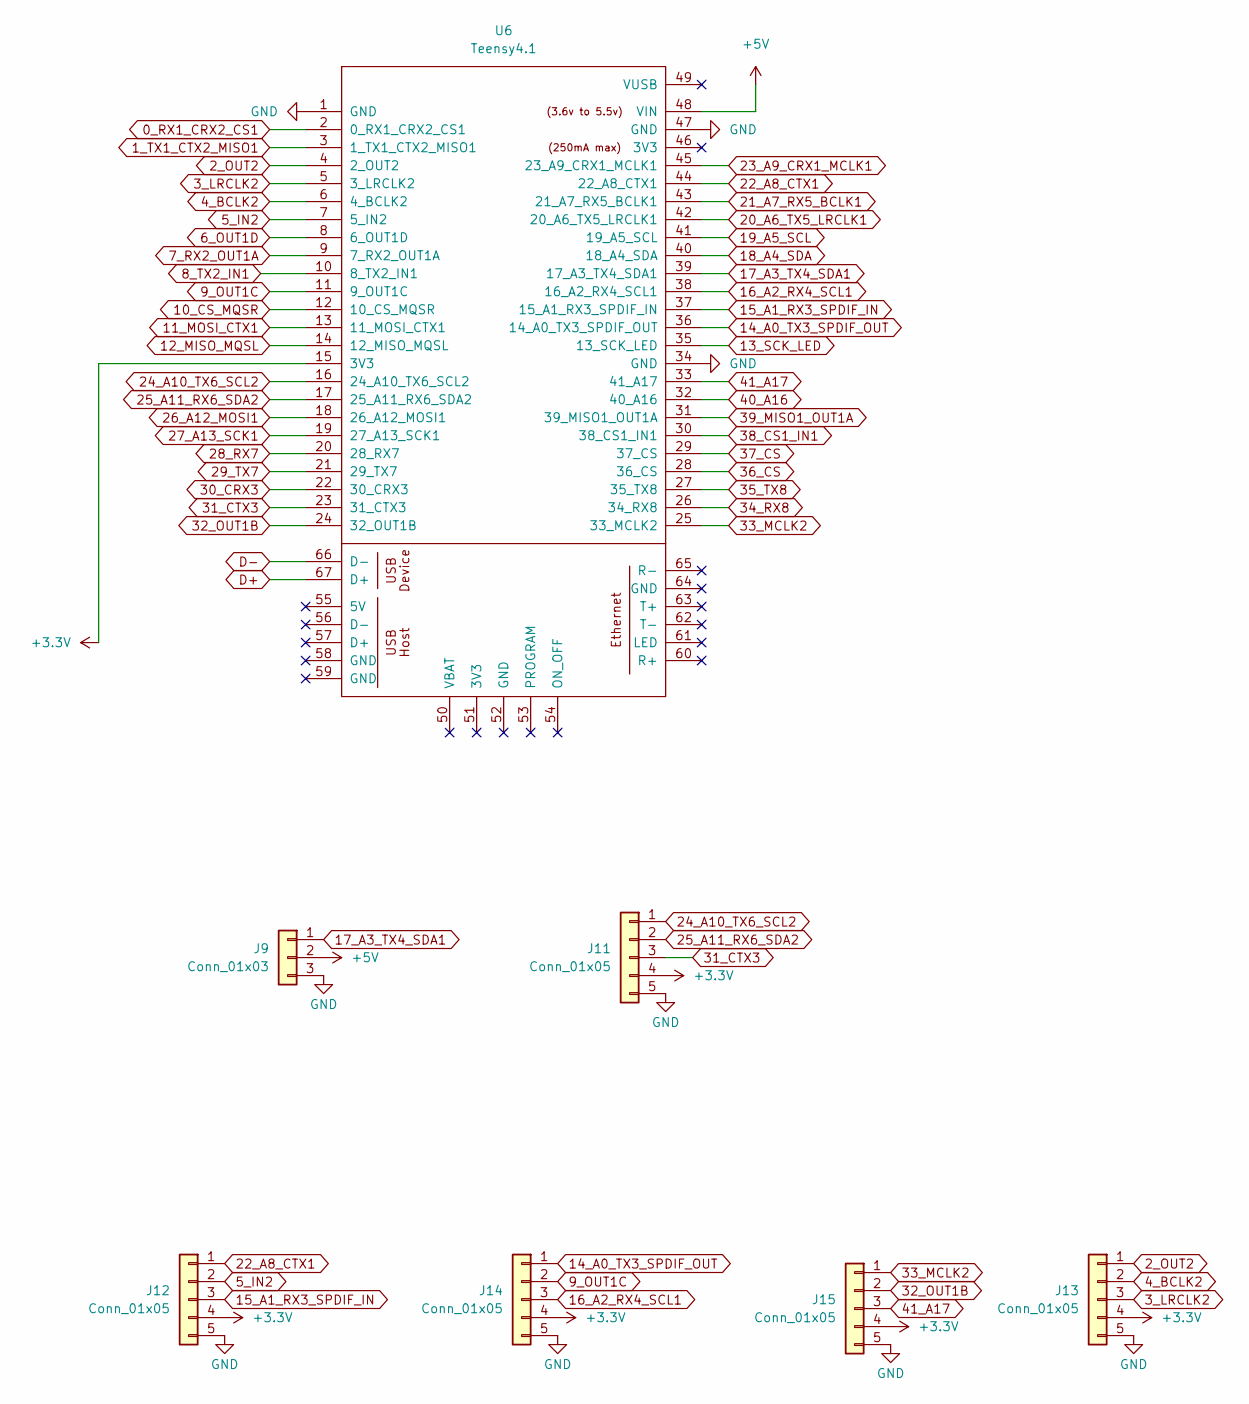
[picture p135: schematic ni404.kicad_sch]

Parts:
J9: Conn_01x03; JST_PH_B3B-PH-K_1x03_P2.00mm_Vertical; lcsc# C131339
J11, J12, J13, J14, J15: Conn_01x05; JST_PH_B5B-PH-K_1x05_P2.00mm_Vertical; lcsc# C157993
U6: Teensy4.1; Teensy41; lcsc# ----

Connections:
0_RX1_CRX2_CS1: U6.2 (0_RX1_CRX2_CS1)
1_TX1_CTX2_MISO1: U6.3 (1_TX1_CTX2_MISO1)
2_OUT2: J13.1, U6.4 (2_OUT2)
3_LRCLK2: J13.3, U6.5 (3_LRCLK2)
4_BCLK2: J13.2, U6.6 (4_BCLK2)
5_IN2: J12.2, U6.7 (5_IN2)
6_OUT1D: U6.8 (6_OUT1D)
7_RX2_OUT1A: U6.9 (7_RX2_OUT1A)
8_TX2_IN1: U6.10 (8_TX2_IN1)
9_OUT1C: J14.2, U6.11 (9_OUT1C)
10_CS_MQSR: U6.12 (10_CS_MQSR)
11_MOSI_CTX1: U6.13 (11_MOSI_CTX1)
12_MISO_MQSL: U6.14 (12_MISO_MQSL)
13_SCK_LED: U6.35 (13_SCK_LED)
14_A0_TX3_SPDIF_OUT: J14.1, U6.36 (14_A0_TX3_SPDIF_OUT)
15_A1_RX3_SPDIF_IN: J12.3, U6.37 (15_A1_RX3_SPDIF_IN)
16_A2_RX4_SCL1: J14.3, U6.38 (16_A2_RX4_SCL1)
17_A3_TX4_SDA1: J9.1, U6.39 (17_A3_TX4_SDA1)
18_A4_SDA: U6.40 (18_A4_SDA)
19_A5_SCL: U6.41 (19_A5_SCL)
20_A6_TX5_LRCLK1: U6.42 (20_A6_TX5_LRCLK1)
21_A7_RX5_BCLK1: U6.43 (21_A7_RX5_BCLK1)
22_A8_CTX1: J12.1, U6.44 (22_A8_CTX1)
23_A9_CRX1_MCLK1: U6.45 (23_A9_CRX1_MCLK1)
24_A10_TX6_SCL2: J11.1, U6.16 (24_A10_TX6_SCL2)
25_A11_RX6_SDA2: J11.2, U6.17 (25_A11_RX6_SDA2)
26_A12_MOSI1: U6.18 (26_A12_MOSI1)
27_A13_SCK1: U6.19 (27_A13_SCK1)
28_RX7: U6.20 (28_RX7)
29_TX7: U6.21 (29_TX7)
30_CRX3: U6.22 (30_CRX3)
31_CTX3: J11.3, U6.23 (31_CTX3)
32_OUT1B: J15.2, U6.24 (32_OUT1B)
33_MCLK2: J15.1, U6.25 (33_MCLK2)
34_RX8: U6.26 (34_RX8)
35_TX8: U6.27 (35_TX8)
36_CS: U6.28 (36_CS)
37_CS: U6.29 (37_CS)
38_CS1_IN1: U6.30 (38_CS1_IN1)
39_MISO1_OUT1A: U6.31 (39_MISO1_OUT1A)
40_A16: U6.32 (40_A16)
41_A17: J15.3, U6.33 (41_A17)
+3.3V: J11.4, J12.4, J13.4, J14.4, J15.4, U6.15 (3V3)
+5V: J9.2, U6.48 (VIN)
D+: U6.67 (D+)
D-: U6.66 (D-)
GND: J9.3, J11.5, J12.5, J13.5, J14.5, J15.5, U6.1 (GND), U6.34 (GND), U6.47 (GND)

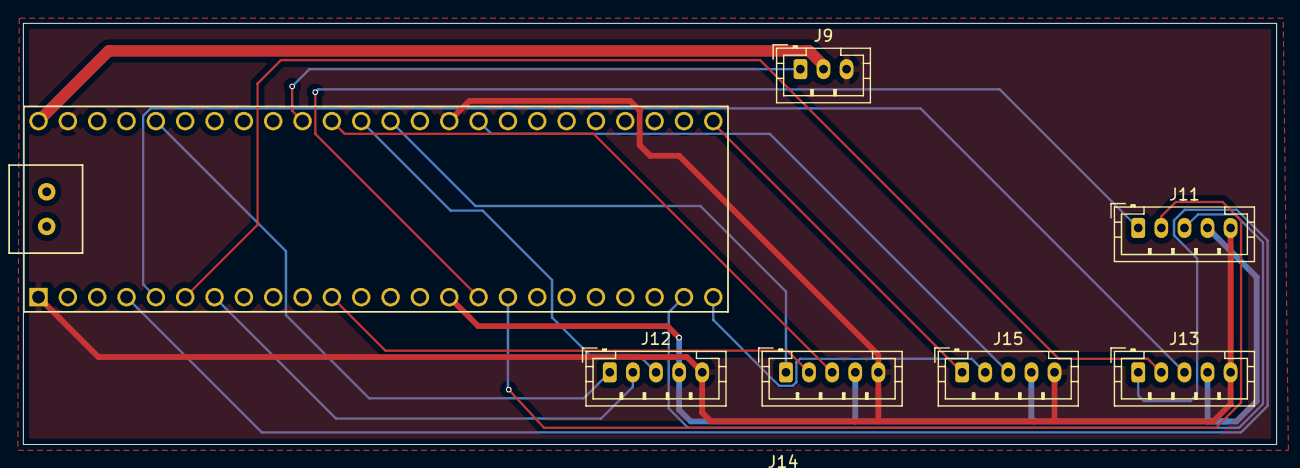
[picture p136: board ni404.kicad_pcb from above]

Board: 2 copper layers, 108.5 x 36.5 mm, 7 parts (0 on the bottom side), 19 nets.
