luigismith/ichosynth/emulator/compat/AudioStream.h

// AudioStream.h — Teensy core header name. Vendored Teensy audio nodes include
// <AudioStream.h>; route it to our Audio.h which defines AudioStream,
// audio_block_t, AUDIO_BLOCK_SAMPLES, allocate/release, etc.
#ifndef NI404_COMPAT_AUDIOSTREAM_H
#define NI404_COMPAT_AUDIOSTREAM_H
#include "Audio.h"
#endif
