luigismith/ichosynth/(commit log)

2026-05-21 Baseline: import upstream NI404 (SP_ soundpauli) unchanged
    Initial fork baseline of the open-source NI404 DIY sampler-sequencer
    (Teensy 4.1 + Audio Shield, 16x16 RGB LED matrix, KY-040 encoders).
    Imported as-is under the original MIT license before any fork changes.
    [BOM.csv, bom.csv, designators.csv, ni404 completed.stl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]
2026-05-21 Add config.h to centralize pins and feature switches
    Move DATA_PIN, NUM_LEDS, encoder CLK/DT pins, and encoder button pins out of
    the sketch into a single config.h, and drive isEncoder4Defined from a
    HAS_ENCODER4 switch. Adds (defaulted-off) OLED_ENABLED and
    MIDI_CLOCK_OUT_ENABLED toggles for the upcoming features so behavior is
    unchanged until they are turned on. Makes the fork easy to retarget to
    hardware variants.
2026-05-21 Add optional SSD1306 OLED status HUD
    New display.h drives a 0.96" 128x64 SSD1306 over the I2C bus already used by
    the SGTL5000 codec (addr 0x3C, SDA 18 / SCL 19). Shows mode, BPM, volume,
    velocity, page/lastPage and play/stop. Refresh is throttled to OLED_FPS and
    skipped unless a shown value changed, so it never stalls the timing-sensitive
    audio loop. Fully compiled out when OLED_ENABLED is 0 (default) - the Adafruit
    libraries are only required when the HUD is turned on.
    [display.h, soundpauli_ni404.ino]
2026-05-21 Add optional MIDI clock OUT (master sync)
    A dedicated IntervalTimer emits usbMIDI realtime Clock at 24 PPQN derived from
    SMP.bpm, plus Start on play and Stop on stop, so external gear can slave to the
    NI404. It only generates clock when not already following an incoming external
    clock (tracked via lastExternalClockMs), so the existing slave path is
    unaffected. Tempo changes update the clock interval. All gated behind
    MIDI_CLOCK_OUT_ENABLED (default 0); behavior is unchanged when off.
2026-05-21 Document fork additions in README
    Add a FORK ADDITIONS section covering config.h, the optional SSD1306 OLED HUD
    (libraries, I2C wiring on pins 18/19, address 0x3C) and optional MIDI clock
    OUT, plus a summary of the new config.h compile switches.
2026-05-21 Add Italian build and usage manuals
    MANUALE_COSTRUZIONE.md: beginner-friendly guide for the fully hand-wired DIY
    build (no custom PCB) - BOM, tools, exact pin map from config.h, SD card layout,
    firmware flashing, and troubleshooting.
    MANUALE_USO.md: usage guide covering the grid model, the 3-4 encoders, drawing/
    erasing notes, transport, volume/BPM, velocity, single mode, sample browser,
    sample packs, save/load and MIDI (incl. the fork's clock out).
2026-05-22 Redesign README: visual hero, fork-vs-upstream comparison, Mermaid diagrams
    Restructure the landing page so the fork's value is clear in seconds:
    - hero with badges (license, platform, manuals) and a one-line fork pitch
    - "What this fork adds" comparison table + collapsible changed-files map
    - Mermaid diagrams for signal flow, shared I2C bus, and MIDI master/slave
    - pin-wiring table sourced from config.h, TOC, and prominent IT manual links
    - preserve upstream attribution to SP_ (soundpauli), PJRC and Nic Newdigate
2026-05-22 Fix TOC anchors: use variation-selector-free emoji in headings
    Headings with VS16 emoji (hammer/slider/gear) generate inconsistent GitHub
    slugs that broke the table-of-contents links. Swap to plain emoji so anchors
    resolve cleanly.
2026-05-22 Redesign Italian manuals with SVG infographics and Mermaid diagrams
    Apply a consistent documentation design system to both guides:
    - hero headers with badges, clickable TOC, emoji-coded callout boxes
    - five hand-built SVG infographics (assets/, generated by _gen_assets.py):
    grid concept, encoder layout+gestures, voice color legend, full wiring
    map (OLED marked as fork), and SD-card folder tree
    - Mermaid diagrams: mode/command state machine and MIDI master/slave (USO),
    assembly flow and firmware-flashing flow (COSTRUZIONE)
    - preserve all technical content (BOM, pin tables, SD structure, troubleshooting)
    [_gen_assets.py]
2026-05-22 Rebuild manuals as image-rich PDFs; add diagram assets and .gitattributes
    - regenerate both PDFs from Markdown via a reportlab converter (assets/_md2pdf.py)
    that embeds the SVG infographics and renders ```mermaid blocks as local PNGs
    (no external service), with styled callouts, tables and code blocks
    - add four local diagram SVGs mirroring the Mermaid charts for PDF use:
    midi-clock, modes-map, assembly-flow, flash-flow
    - add .gitattributes so PDFs/images/CAD files are stored as binary (no EOL
    mangling) and text stays LF
    - ignore transient render folders (assets/_preview, assets/_pdfcheck)
2026-05-22 Rebrand manuals to ichosynth (keep NI404 attribution to SP_)
    - titles, body, infographics and PDFs now refer to the device as "ichosynth"
    - add a hero "fork di NI404 (SP_)" badge and an explicit credit line in the
    intro and footer of both guides
    - add a "Novità del fork" callout summarizing the fork features (centralized
    config.h, 3/4-encoder switch, OLED HUD, MIDI clock OUT master)
    - keep literal references intact: soundpauli_ni404.ino, "originale NI404"
    - regenerate sd-structure / midi-clock SVGs and rebuild both PDFs
2026-05-22 Doc renderer: note that code blocks must stay verbatim; ignore __pycache__
    reportlab Preformatted renders text literally (no XML parsing), so code-block
    content must NOT be entity-escaped. Add a clarifying comment to prevent a
    regression, and gitignore Python bytecode caches.
    [_md2pdf.py]
2026-06-10 Make this a fully-playable 3-encoder build (HAS_ENCODER4 0)
    Upstream's 3-encoder mode only remapped knob *rotation* (volume -> left knob)
    and left Play/Pause, Volume/BPM, Menu and Note-Shift on the absent 4th button,
    making a 3-knob build unusable for those actions. This commit remaps those
    gestures onto the three remaining buttons, guarded by !isEncoder4Defined so the
    4-encoder build is unchanged.
    Firmware (soundpauli_ni404.ino):
    - force buttons[4]=0 when !isEncoder4Defined (neutralize the missing 4th button)
    - Play/Pause -> double-click CENTER ("0003")
    - Volume/BPM in -> hold RIGHT + hold CENTER ("0202"); out -> click CENTER ("0001")
    - Menu -> click LEFT + hold CENTER ("10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
    [_gen_assets.py, config.h, soundpauli_ni404.ino]
2026-06-10 Fix real build bugs found by compile-check; add setup scripts + wavmaker.exe
    Compile-checked the firmware with arduino-cli (Teensy 4.1) and fixed two genuine
    bugs the build surfaced:
    - config.h: a "*/" sequence inside a comment (ENC_MIDR_*/BTN_MIDR) closed the
    block comment early, so trailing text was compiled as code.
    - include order: config.h (which defines DATA_PIN / NUM_LEDS) was included
    before <FastLED.h>, clobbering FastLED's WS2812Serial template parameter
    names. Moved the config.h include after FastLED.h (canonical pattern).
    Dev-environment tooling:
    - scripts/setup-dev-env.{sh,ps1}: one-shot installer (Teensy core + libs +
    ResamplingReader patch + compile-check). Pins FastL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
    [config.h, soundpauli_ni404.ino]
2026-06-10 setup scripts: remove registry newdigate copies before installing from GitHub
    TeensyAudioSampler (teensy-polyphony) and TeensyVariablePlayback exist in both
    the Arduino registry and GitHub, under different folder names. Installing the
    GitHub HEAD copies (the only mutually-compatible pairing) while a registry copy
    is still present yields two libraries exporting the same headers — a duplicate-
    library conflict. Uninstall the registry copies first so the script is
    idempotent on machines that already have them.
2026-06-10 Rebuild manual PDFs (3-encoder layout + wavmaker.exe note)
    Regenerate both PDFs from the updated Markdown so they match the current
    3-encoder docs and the new wavmaker.exe instructions in the build manual.
2026-06-10 wavmaker: add a friendly GUI, ship it as wavmaker.exe
    Add _SDCARD/wavmaker_gui.py — a tkinter GUI (stdlib only) that makes sample
    prep easy and safe:
    - add files or a whole folder; each row shows the current format and its
    target _<n>.wav name; rows already in mono/16-bit/44.1kHz are highlighted
    - start-number field with a live "goes into samples/<n>/" hint
    - separate output folder (originals are kept by default; deleting is opt-in
    with a confirm), progress bar + log, conversion off the UI thread
    - ichosynth dark theme
    Rebuild wavmaker.exe from the GUI (PyInstaller --windowed, audioop-lts bundled);
    the console wavmaker.py stays for CLI/scripting. Verified: conversion logic
    (stereo 48k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
2026-06-10 wavmaker GUI: add an (i) info button crediting the developer
    Add an "ⓘ" button in the header that opens an About dialog: app name, version,
    "Sviluppato da Luigi Massari (luigismith)", a clickable repo link, and the
    ichosynth / NI404 (SP_) / MIT line. Rebuild wavmaker.exe; verified the dialog
    renders and the exe launches.
2026-06-10 README: tell the ICHOS 2026 story and polish the landing page
    ichosynth is the instrument participants build in ICHOS 2026 — Francesco
    Giannico's residential sound-ecology workshop in Taranto (12–14 Jun 2026),
    where the synth build is led by Luigi Massari. Add:
    - a "Part of the ICHOS project" section near the top, with the workshop's
    listen → field-record → build → perform arc, the three marginal sites, the
    ἦχος ("sound") etymology, the Vicoli Corti documentary, and the project link
    - a new assets/ichos-project.svg infographic (generated by _gen_assets.py)
    - an ICHOS badge, expanded credits (Giannico / Massari / Trani) and a new
    Taranto-flavoured footer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
2026-06-10 Make the repo fully bilingual (English + Italian) and add a dev-env manual
    Every doc now exists in both languages with a flag switcher at the top:
    - README.md (EN) ↔ README.it.md (IT)
    - BUILD_MANUAL.md (EN) ↔ MANUALE_COSTRUZIONE.md (IT)
    - USAGE_MANUAL.md (EN) ↔ MANUALE_USO.md (IT)
    - DEV_ENVIRONMENT.md (EN) ↔ MANUALE_AMBIENTE.md (IT) ← new dev-environment
    setup guide (Windows + macOS): arduino-cli one-shot script, FastLED 3.9.10,
    newdigate libs from GitHub, ResamplingReader patch, wavmaker note.
    English docs reuse the Italian infographics (by choice) with English alt text;
    Mermaid node labels are translated per language. The README "Manuals" section
    now lists all three guides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
2026-06-11 Add a per-voice lowpass filter on a single pushbutton (3-encoder build)
    Finishes the filter the upstream firmware left half-built: every voice already
    runs through an AudioFilterStateVariable (lowpass output) whose cutoff was never
    set, so it sat at the library's accidental 1 kHz default. Now it's controlled.
    Hardware: stays a 3-encoder build. One plain momentary pushbutton between pin 41
    (the original 4th-encoder switch spot) and GND, internal pull-up. No 4th encoder.
    UX: HOLD the FILTER button + TURN the CENTER knob = lowpass cutoff of the voice
    under the cursor (same indexing as mute). A 2-row LED bar shows the cutoff in the
    voice's colour; encoders detach during the hold and are restor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
2026-06-11 wavmaker v1.1: SD card scan, structure builder & FAT32 prep
    Add an "SD card" panel to the WAV Maker GUI so the SD can be prepared
    without effort:
    - Scan a given SD path: read filesystem, drive type, capacity/free space
    - Detect the firmware's samples/<bank>/_<n>.wav layout, count samples and
    auto-resume numbering from the next free slot (bank = n // 100)
    - Create/complete the directory structure (samples/0..9) non-destructively
    - Format & prepare FAT32 when the card is unformatted / incompatible (NTFS) /
    has odd partitions, with strong safeguards: removable-only, never the system
    drive, explicit "erase all" confirmation, optional deep clean+repartition,
    graceful admin-required and >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
2026-06-11 Add ichosynth Flasher: one-click GUI to flash the Teensy 4.1
    A small companion GUI (sibling to the WAV Maker) that loads the ichosynth
    firmware onto a Teensy 4.1 without needing arduino-cli:
    - ships a pre-compiled ichosynth.hex
    - live Teensy detection (running / bootloader / absent), polled every 3s
    - one-click flash: auto-reboot into the bootloader, and if that fails it asks
    the user to press the PROGRAM button; success is confirmed by watching the
    USB re-enumeration (HalfKay -> RUN)
    - auto-detected flashing backend: standalone teensy_loader_cli.exe if present
    (fully self-contained), otherwise the installed Teensyduino tools
    - info dialog crediting the developer
    Validated end-to-end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
2026-06-11 wavmaker v1.1: deduce SD destination, hide manual fields under Avanzate
    After scanning the SD the destination (samples/) and the next free number are
    deduced automatically and shown as a single summary line, instead of editable
    "start number" / "destination folder" fields. Those overrides moved into a
    collapsible "Avanzate" section: force start number, write to a local folder
    instead of the SD, delete originals. Conversion stays incremental and always
    writes the firmware layout samples/<bank>/_<n>.wav. Rebuilt wavmaker.exe.
2026-06-11 Flasher: built-in pure-Python Teensy 4.1 loader (no Teensyduino needed)
    Add teensy_native.py: a self-contained Windows HID flasher that talks to the
    HalfKay bootloader directly (ctypes + setupapi/hid.dll), so the flasher no
    longer needs Teensyduino or any external binary to flash. It is an independent
    reimplementation of the documented HalfKay protocol (VID 0x16C0 / PID 0x0478,
    1024-byte blocks, Intel-HEX with the Teensy 4.x 0x60000000 FlexSPI offset);
    no third-party code is bundled. The board is put into the bootloader via the
    PROGRAM button (reliable — software reboot is not available on Win32, as even
    teensy_loader_cli notes). Writes retry per block to handle HalfKay's NAKs.
    Validated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
2026-06-11 Add workshop materials: handouts, slide deck, instructor notes
    _WORKSHOP/ — materials for the ICHOS 2026 build day:
    - QUICKSTART_COSTRUZIONE (md+pdf): bench lab-sheet (checklist, pin map, the 6
    assembly phases, one-click flash, first boot, quick troubleshooting)
    - FASCICOLO_CORSISTA.pdf: the Costruzione + Uso manuals merged into one
    illustrated participant packet
    - ICHOSYNTH_Costruzione.pptx: 19-slide construction-focused deck (ichosynth dark
    theme, embedded infographics, per-slide instructor notes)
    - APPUNTI_DOCENTE (md+pdf): instructor sheet — day schedule, per-phase talking
    points, the 6 most common mistakes to catch, bench prep
    _HANDOFF.md — project state + how to resume o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
2026-06-12 Add intro doc: the Teensy and how the firmware works
    _WORKSHOP/INTRO_TEENSY_E_CODICE (md+pdf): an accessible "cappello introduttivo"
    for the workshop — what the Teensy 4.1 is and why it's the heart of the build,
    and a broad-strokes walkthrough of the firmware (setup/loop, the background audio
    graph, the 16x16 grid as display+sequencer, PSRAM, and the fork additions),
    grounded in the real code. 4 pages, embeds the grid-concept infographic.
2026-06-14 Add desktop emulator (NI404 + TŒRN) with sample loader, demo and CI
    Native C++ desktop emulator (Windows + macOS) that recompiles the real
    firmware against Teensy/Arduino compatibility shims (emulator/compat/) and
    drives it with SDL2: 16x16 LED grid, SSD1306 OLED HUD, audio graph, keyboard
    + MIDI input, in-window settings menu.
    Highlights:
    - Drag-and-drop sample loader: any WAV (8/16/24/32-bit or float, mono/stereo,
    any rate) -> 16-bit mono 44.1kHz, installed on the virtual SD (folder 9) and
    loaded into the current channel (src/sample_import.*). Also via --import.
    - Rich 4-page demo song (Am-F-C-G): 8 drum samples + 2 synth voices, sample
    pitch-by-row, per-channel filters, velocity d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
2026-06-14 CI: fix workflow startup failure + build macOS with GCC
    - Fix YAML startup_failure: the Windows job's `defaults.run.shell` was written in
    flow style `{ shell: msys2 {0} }`, whose `{0}` is invalid YAML (no jobs ran).
    Switch to block style.
    - macOS must build with Homebrew GCC, not Clang: the firmware needs -fpermissive
    (assigns to a const String[] element, etc.) which Clang has no equivalent for.
    Select the newest Homebrew g++ in CI and in scripts; static-link libstdc++/libgcc
    on Apple+GNU so only SDL2 is bundled.
    - Add scripts/mac-build.sh: one-command local macOS build (toolchain + GCC build +
    SDL2 bundle via dylibbundler + sample card) producing a self-contained app.
    - build.sh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
2026-06-14 macOS/GCC: skip CoreMIDI (GCC can't parse Apple block headers)
    A Homebrew-GCC macOS build (needed for -fpermissive) cannot compile Apple's
    CoreMIDI/CoreFoundation headers (block ^ syntax). Guard the CoreMIDI backend on
    __clang__ so a GCC build uses the no-MIDI stub; keyboard, audio and drag-drop
    sample loading still work. CI macOS job was failing at 'Build ni404emu'.
    [midi_in.cpp]
2026-06-14 Add --play self-test: drive the real sound engine and verify it
    Headless "play it" harness that exercises the instrument like the hardware and
    asserts musical correctness: all 8 sample channels from the MIDI keyboard, key
    pitch, both synth voices, the per-channel lowpass (bright source, open vs closed
    cutoff measured in isolation), and full 4-page playback (playhead 1..64, loud,
    no clipping/NaN). Adds play hooks (ni404_play_note/play_synth/set_filter/
    load_sample + beat/page/playing/bpm readers) used only by --play; toern stubs.
    Verified: all checks PASS. The one apparent filter "incongruity" was a test
    artifact (voice bleed from prior notes + peak vs energy); measured in isolation
    the filt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
    [firmware.cpp, main.cpp, ni404_host.h]
2026-06-14 --play: add editing-workflow verification (cursor + note placement)
    Extend the "play it" self-test to drive the real composition workflow: move the
    grid cursor with the encoders (ENC_LEFT=row, ENC_CENTER=column) and place notes
    with the centre button via the real paint() path, then read the grid back. Adds
    cursor/mode/note read-back hooks (toern stubs).
    Driving it surfaced the genuine hardware input timing — button gestures are acted
    on ~80 ms after they change (the firmware's reset-timer fires checkMode() then
    clears the buttons) — which the emulator reproduces faithfully; the test now holds
    the button ~110 ms. All checks PASS: editing, filter, 8 sample channels, key
    pitch, both synth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
    [firmware.cpp, main.cpp]
2026-06-17 Firmware: 4 encoders + 3 buttons, TŒRN-style filter, live recording
    - HAS_ENCODER4=1: the 4th encoder (pins 32/33, btn 41) is now wired and is
    contextual — in DRAW/SINGLE its rotation sweeps the per-voice lowpass cutoff of
    the voice under the cursor (TŒRN 'fast filter': just turn, no button; the knob
    auto-syncs to each voice's stored cutoff), volume in VOLUME/BPM, sample-end seek
    in the browser. The standalone filter button is removed.
    - 3 tact switches (pins 24/25/26, BUTTONS3_ENABLED): PLAY / MENU / REC, wired to
    the existing togglePlay()/switchMode() and the recorder.
    - Live recording (RECORD_ENABLED): AudioInputI2S + AudioRecordQueue in the graph;
    hold REC to record fro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
2026-06-17 Emulator: on-screen touch controls, recording, SD management, multi-format import
    - On-screen mouse/multi-touch controls below the OLED: 4 knobs (grab the RIM to
    rotate, press the CENTRE for the button, centre-drag = hold+turn) + PLAY/MENU/REC
    buttons; realistic small/centred OLED; width-safe settings menu.
    - Multi-format sample import: drag a WAV/MP3/FLAC onto the window -> decoded via
    vendored dr_libs (public domain), resampled, installed on the SD, loaded.
    - SDL audio capture backend (audio_capture.cpp) feeding the AudioRecordQueue shim,
    so the firmware's recording path gets real input from the selected device.
    - SD management in the menu: show path + open folder, switch SD by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
2026-06-17 Docs: 4-encoder layout, TŒRN-style filter, recording, SD management & emulator
    - README (EN/IT): 4-encoder + 3-button wiring table, config flags (HAS_ENCODER4=1,
    BUTTONS3_ENABLED, RECORD_ENABLED), filter on the 4th encoder, live recording,
    desktop emulator.
    - emulator/MANUALE.md: on-screen touch controls, realistic OLED, WAV/MP3/FLAC
    import, recording (hold REC), SD management + sample browser, single build.
    - _DOCS/MAPPA_CONTROLLI.md (new): TŒRN -> ichosynth control map + implementation status.
    - emulator/STATUS.md / STATUS-toern.md: progress notes for the above.
2026-06-17 Firmware: per-voice bitcrusher FX (first TŒRN effect ported)
    - BITCRUSH_ENABLED: an AudioEffectBitcrusher inserted on each of the 8 sample
    voices (filterN -> crushN -> mixer). Default = bypass (16-bit, 44.1 kHz) set at
    boot via applyAllCrush(), so it's transparent until a voice is crushed.
    - crushBits[] per-voice param + applyCrush()/applyAllCrush(); AudioMemory bumped
    64 -> 96 for the extra nodes.
    On-device control is the upcoming FX MODE (no free encoder in DRAW); for now the
    engine is driven by the ni404_set_crush() hook (used by the emulator --play test).
2026-06-17 Emulator: bitcrusher hook + --play checks (crush + 4th-encoder filter)
    - ni404_set_crush() hook (firmware.cpp; toern stub) + declaration.
    - --play: new bitcrusher check (crushed voice differs from clean), and the filter
    check now drives the real 4th encoder (ENC_4TH) instead of the direct set, since
    the fast-filter loop owns the cutoff. All checks PASS (filter closes hi-hat to 2%,
    crush alters the signal, 8/8 channels sound).
2026-06-17 Docs: per-voice bitcrusher (first TŒRN effect)
    README (EN/IT) config tables, emulator/STATUS.md and _DOCS/MAPPA_CONTROLLI.md note
    the bitcrusher engine (default bypass) and that on-device control is the next FX MODE.
2026-06-18 Firmware: per-voice Moog ladder filter (2nd TŒRN effect)
    - LADDER_ENABLED: an AudioFilterLadder after the crusher on each of the 8 sample
    voices (filterN -> crushN -> ladderN -> mixer). Default open (~18 kHz, no
    resonance) = transparent; ladderCut[]/ladderRes[] params + applyLadder()/
    applyAllLadder(); AudioMemory 96 -> 120. Requires BITCRUSH_ENABLED (shared FX chain).
2026-06-18 Firmware: FX MODE — hold MENU to edit per-voice effects on 4 sliders
    New fxMode (FXMODE_ENABLED): holding MENU in DRAW/SINGLE turns the 4 encoders into
    sliders for the voice under the cursor — E1 lowpass cutoff, E2 ladder cutoff, E3
    ladder resonance, E4 bitcrush — shown as 4 colour-coded bars on the grid; tap MENU
    to exit. Encoders are seeded from the voice's current FX values on entry (no jump);
    only sample voices 1..8. Gives the bitcrusher + ladder an on-device control.
2026-06-18 Docs: FX MODE (hold MENU) for the per-voice effects
    README (EN/IT) config tables, emulator/MANUALE.md, STATUS.md and MAPPA_CONTROLLI.md
    describe FX MODE: hold MENU -> 4 encoder sliders (cutoff / ladder cut / ladder reso /
    bitcrush) of the cursor voice, tap MENU to exit.
2026-06-18 Firmware: save recordings to SD (persist past restart)
    On REC release the take is written to samples/9/_9NN.wav (next free) via saveRecording()
    + writeWavHeader() (16-bit mono 44.1k), and the channel is pointed at it (SMP.wav[ch]),
    so the recording persists on disk and reloads — not just RAM.
2026-06-18 Docs: recordings are saved to SD
    README (EN/IT), MANUALE, STATUS, MAPPA_CONTROLLI note that REC takes are written to
    samples/9/ and persist.
2026-06-18 Firmware: REC count-in (4 beats synced to tempo, like TŒRN ON1)
    Hold REC -> a 4-beat count-in at the song BPM (shows 4-3-2-1 on the grid) before
    recording begins; release stops + saves. Millis-based in loop() (not the playTimer
    ISR), so it works whether the sequencer is playing or stopped; tap-release during the
    count cancels it.
2026-06-18 Docs + gitignore: REC count-in; ignore user recordings (_SDCARD/samples)
    MANUALE / STATUS / MAPPA_CONTROLLI document the 4-beat count-in; .gitignore excludes
    runtime user recordings under _SDCARD/samples/.
2026-06-19 Port: real TŒRN firmware now builds for our hand-soldered Teensy 4.1
    Compile the unmodified TŒRN sketch against two drop-in drivers so it runs on
    cheap hand-wired parts: 4 KY-040 encoders (i2cEncoderLibV2.h re-implements the
    Duppa API) + 3 tact switches (FastTouch.h) instead of 4 I2C RGB encoders and 3
    capacitive touch pads. Produces a flashable .hex.
    - teensy/build_toern.py: reproducible build (clone toern-src if missing, stage,
    remap pins, compile, export teensy/firmware/toern.hex; --flash to flash).
    - teensy/libraries/{i2cEncoderLibV2,FastTouch}: the two replacement drivers.
    - teensy/README.md: port overview, pin map, footprint, remaining work (OLED HUD).
    Two gotchas the build handl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
    [build_toern.py]
2026-06-19 Port: OLED HUD (FLASHMEM SSD1306) + collision-free pin map
    OLED HUD as its own library (teensy/libraries/IchosOled): a minimal SSD1306 text
    driver with all code in FLASHMEM and the font in PROGMEM, so it costs ~80 bytes of
    RAM1 (TŒRN leaves only ~700 free; Adafruit_GFX/U8g2 overflow the link). Shows
    channel / mode / transport / BPM / volume / page on the shared Wire bus. Kept out of
    TŒRN's giant translation unit so it does not crash the compiler. build_toern.py wires
    in the begin()/render() calls automatically.
    Pin map reworked to avoid TŒRN's hard-coded GPIO and the Audio Shield:
    - E4 encoder 4/2/3 -> 37/38/39 (4=TŒRN output, 2=connection read, 3=switch)
    - buttons 24/25/26 -> 25/26/28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
    [build_toern.py]
2026-06-19 Port: trim 2nd LED strip; add feature inventory
    build_toern.py now applies requested feature trims as build-time patches (toern-src
    stays pristine). First trim: drop the optional reactive 256-LED strip — stop driving
    pin 24 and skip its per-frame update. Frees pin 24 and a little CPU.
    _DOCS/FEATURE_INVENTORY.md: full catalogue of the firmware's features with weight and
    removability notes, to drive lightening decisions.
    [build_toern.py]
2026-06-19 Docs: reframe everything around ichosynth = a hand-built TŒRN
    Comprehensive documentation pass. The product is now the real TŒRN firmware running
    on our hand-soldered hardware (4 KY-040 + 3 tact switches + I2C OLED), still called
    ichosynth; the old NI404-fork firmware is a fallback/reference.
    - README.md / README.it.md: reframed as a low-cost, hand-soldered build of TŒRN;
    new pin map, build via teensy/build_toern.py, full TŒRN feature list, credits.
    - USAGE_MANUAL / MANUALE_USO: rewritten around TŒRN controls (4 encoders + B1/B2/B3
    PLAY/MENU/REC, combos, OLED HUD), grounded in _DOCS/MAPPA_CONTROLLI.md.
    - BUILD_MANUAL / MANUALE_COSTRUZIONE / _DOCS/wiring.txt: TŒRN-port pin map
    (E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
2026-06-19 Emulator: one-command launcher to run a chosen firmware variant
    emulator/run.py builds and launches the emulator with the firmware you want to test:
    the real TŒRN (default, toernemu — same source teensy/build_toern.py flashes) or the
    NI404 bench fallback (--bench). It auto-detects the MSYS2/MinGW64 toolchain on Windows,
    clones the TŒRN sources if missing, and resolves the build tools against that toolchain
    PATH (Windows CreateProcess otherwise ignores a passed env PATH). Lets you iterate on
    synth variations on the same modelled hardware before flashing. Documented in
    emulator/MANUALE.md §1.
    [run.py]
2026-06-19 Regenerate derived artifacts for the TŒRN-port hardware
    - assets/wiring-map.svg, encoders.svg, modes-map.svg: redrawn for the current
    hardware (4 KY-040 + 3 buttons + OLED) and the collision-free pin map (E4 37/38/39,
    buttons 25/26/28, OLED 18/19); dropped the "fork"/config.h framing.
    - Manual PDFs (BUILD/USAGE/DEV in EN+IT): regenerated from the updated Markdown via a
    new Node+Chrome pipeline (scripts/pdf), with mermaid rendered and the SVGs inlined.
    - _FLASHER/ichosynth.hex: now the built product firmware (the real TŒRN port,
    teensy/firmware/toern.hex) so the one-click flasher flashes the instrument.
2026-06-22 Fix stale NI404-fork framing across repo + GitHub About
    The GitHub About still described ichosynth as "a fork of NI404 adding OLED, MIDI
    clock master sync, single-file config" — updated (via gh) to: a hand-soldered, low-cost
    build of TŒRN running the real TŒRN firmware. Swept the rest of the repo for the same
    stale framing and the superseded pin map:
    - assets/_gen_assets.py: the SVG generator (source of truth) still drew 3 encoders,
    old pins (E4 4/2/3), the OLED as an optional "fork" add-on, and a config.h/Arduino-IDE
    flash flow. Rewrote gen_encoders/gen_wiring/gen_modes/gen_assembly/gen_flash to the
    current hardware (4 KY-040 + 3 buttons 25/26/28 + standard OLED) and the build_to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
    [_gen_assets.py, build_toern.py]
2026-06-22 Add Line In/Out on 6.35mm mono jacks (+ keep 3.5mm headphone)
    Hardware + docs addition (no firmware change needed):
    - Line In: 1x 6.35mm mono jack -> Audio Shield LINE IN L pad. TŒRN already records
    the left line-in as a mono sample and LINE IN is the default record input.
    - Line Out: stereo on 2x 6.35mm mono jacks -> LINE OUT L / LINE OUT R pads (TŒRN
    pans voices, so two jacks preserve the stereo image; the DAC drives line out and
    the headphone together).
    - On-board 3.5mm stereo headphone jack kept for monitoring.
    - assets/_gen_assets.py: new gen_audio_io() -> assets/audio-io.svg (jacks <-> Audio
    Shield pads); wiring-map audio-shield sub-label updated. Regenerated assets.
    - _DOCS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
2026-06-22 Add ichosynth design system (Claude Design) + local card library
    design/ is a local component library synced to a Claude Design project on
    claude.ai/design (project: "ichosynth"). Each .html is a self-contained preview
    card with an @dsCard marker:
    - foundations/: colour palette + typography tokens
    - brand/: logo lockup + badge style
    - diagrams/: the assets/*.svg inlined as standalone cards
    design/_build_design.py regenerates every card from the design tokens and the
    current assets (diagram SVGs inlined so cards render on their own). Pushed via the
    DesignSync tool.
2026-06-22 Add TŒRN factory sample set on SD + rewrite wavmaker for the TŒRN layout
    Samples (public domain, from psemiletov/drum_sklad):
    - _SDCARD/build_samples.py downloads + converts to mono/16-bit/44100 WAV
    - 6 samplepacks 0/..5/ (each 1.wav..8.wav): 0=factory 808, 1=808, 2=Drumulator,
    3=Cheetah SpecDrum, 4=Technics DP50, 5=Soviet Rokton/Lel
    - browser library samples/<kick|snare|hat|clap|tom|perc|fx>/
    - removed legacy NI404 _<n>.wav files (not loaded by the TŒRN firmware)
    wavmaker rewritten for the TŒRN SD layout:
    - two modes: Samplepack (8 WAVs -> <pack>/1-8.wav) and Browser (samples/<cat>/<name>.wav)
    - pure-Python WAV codec (PCM 8/16/24/32-bit, float, EXTENSIBLE) - no audioop/ffmpeg,
    work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
2026-10-30 Add 3D-printed case (_CASE) with Blender renders and graphic assembly guide
    Stepped enclosure for the Anycubic Kobra S1 (250x250): 3 parts on 2 plates,
    no supports. Plate 1 (opaque): tray + control panel. Plate 2 (translucent):
    diffuser with an integrated 16x16 light baffle (color change at Z=1.4).
    - build_case.py: parametric generator (manifold3d) -> stl/, plate-fit check.
    Matrix zone 16 mm, control zone 29 mm (stacked Teensy 4.1 + Audio Rev D).
    2x2 encoders (E2 E3 top, E1 E4 = TOERN cursor Y/X bottom), OLED above,
    flexible tab buttons cut into the panel pressing 6x6x4.3 switches that sit
    on posts rising from the tray floor. USB + PHONES on the back (the Rev D
    headphone jack is o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
2026-10-30 Fix firmware port blockers, harden tools, add illustrated wiring guide
    Full code review (firmware port, desktop tools, emulator) and fixes.
    Firmware (teensy/):
    - FastTouch: TŒRN sets SWITCH_n to INPUT_PULLDOWN, so buttons to GND read
    "pressed" and the firmware hung in INIT MODE at boot. build_toern.py now
    patches them to INPUT_PULLUP and the driver re-asserts the pull-up on every
    read, lets it settle before the first sample (CLR RAM / EEPROM wipe) and
    debounces.
    - i2cEncoderLibV2: push debounce, Encoder created once (TŒRN re-calls begin()),
    readStatus() returns the status byte without side effects, configurable
    counts per detent.
    - IchosOled: 400 kHz bus, no full-screen clears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
2026-10-30 Restyle the manuals: illustrated build manual, light diagrams, branded PDFs
    - MANUALE_COSTRUZIONE / BUILD_MANUAL rewritten: case render on top, parts
    with thumbnails, the Teensy + audio-board stacking, wiring section with the
    real-part illustrations (Teensy 4.1 pinout, KY-040, buttons, OLED, matrix,
    LINE IN, lever-connector power bars), case, firmware (flasher first), SD,
    first power-on, troubleshooting, pin summary. Links to the graphic guides.
    - MANUALE_USO / USAGE_MANUAL: top-view render, real panel layout (E2 E3 top,
    E1 E4 bottom), correct SD paths (samples/<cat>/<name>.wav, packs 0-99 with
    1-8.wav), LINE IN as default record input, count-in only in REC mode ON1.
    - assets/*.s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
2026-10-30 Case: audio board rests on the Teensy; lower case; Anycubic Slicer Next project
    - The audio board sits directly on the header plastic (STACK_GAP 2.6, was 11).
    The control zone height is now the tallest of stack / LINE IN jack / KY-040:
    21.5 mm instead of 29. LINE IN moved next to the audio board (only the panel
    above it). USB and headphones share one rear window as wide as the audio
    board; labels moved beside it. Long-header pin tips modelled above the board.
    - Plugs modelled at realistic size (micro-USB 10.5x7, headphone plug 8 mm),
    headphone jack offset towards a corner of the board edge.
    - check_fit: 0 failures; mutation tests updated (stack taller than the case,
    LINE IN jack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
2026-10-30 Reorganize the repo into clear folders; new README, banner and folder guides
    Layout (no more files dumped in the root or underscore folders):
    docs/manuals/ the six manuals (EN + IT, .md + .pdf) <- root
    docs/wiring/ CABLAGGIO guide + generator, wiring.txt <- _DOCS/
    docs/reference/ control map, feature inventory <- _DOCS/
    docs/workshop/ ICHOS 2026 material <- _WORKSHOP/
    docs/HANDOFF.md <- _HANDOFF.md
    firmware/ build_toern.py, libraries/, patches/ <- teensy/, _DOCS/
    (build output now firmware/build/toern.hex)
    case/ 3D-printed case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
2026-10-31 Case: bigger engraved labels; LINE IN label was never cut
    The panel prints upside down, so its labels sit on the bed and the squashed
    first layer closed the thin grooves. Labels are now 4-6.5 mm (stems ~0.75-0.95
    mm instead of ~0.5): encoders 5.0, buttons 4.0, logo 6.5. Clearances checked:
    >= 1.5 mm from knobs, button tabs, screws and each other.
    The LINE IN label sat above the 3/8" nut at z 19.3-21.1, above the tray wall
    (19.0), so it was never engraved. It now sits in front of the nut, at jack
    height. PHONES/USB (3.8) are centred between the rear opening and the start
    of the rounded corner.
    Rebuilt STLs, check_fit (0 failures), both slicer projects re-sliced headless.
    Renders not regener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
2026-11-01 Case: control zone 7 mm taller (28.5 mm); real header pins, round LINE IN jack
    First printed prototype: the Teensy's long male headers (soldered along the
    whole board, wires soldered on the tips) hit the OLED and lifted the panel.
    The case modelled only 2.5 mm of pin above the audio board.
    - Height now comes from the real stack: pin tips HDR_PIN_UP = 10.9 mm above
    the Teensy PCB (15 mm header) + PIN_TOP_CLR = 8.5 (solder/wire bend, OLED
    pins and wires, OLED PCB + glass). Control zone 21.5 -> 28.5 mm (+7).
    - parts.py: headers modelled full length, pins up to the real tip height.
    - LINE IN jack: room for a round body up to 20 mm (JACK_BODY_H 21), jack
    centre raised to 13 mm so it clears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
2026-11-03 Case renders and assembly guide redone with the 28.5 mm control zone
2026-11-04 Work from any computer: setup covers the case tools, cross-platform paths, handoff
    - tools/setup-dev-env.ps1/.sh also install case/requirements.txt (new) and the
    PDF tools (npm in tools/pdf).
    - Chrome/Edge lookup shared (make_cablaggio.find_chrome, used by make_guide):
    Windows + macOS paths, PATH, or CHROME=...
    - make_slicer_project.py: Anycubic Slicer Next on Windows or macOS (or
    ICHOS_SLICER=...); low priority via nice outside Windows.
    - case/render/render.sh: render.ps1 twin for macOS/Linux (nice 10, few threads).
    - Scratch tools moved into the repo: case/mutation_test.py (mutation tests of
    check_fit, all 13 detected) and tools/checklinks.py (links + anchors, 0 broken).
    - docs/HAN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
2026-11-04 Case: OLED 3 mm right, its pins clear the Teensy's pin 41 (E2 switch)
    The OLED's GND pin sat 2.0 mm above the tip of Teensy pin 41, the E2 encoder
    switch, which carries a soldered wire: solder or wire could short E2 to GND.
    OLED_C (29, 122) -> (32, 122): clearance now 2.72 mm.
    - check_fit: new check, OLED pins >= 2.5 mm from the Teensy's pins.
    - mutation_test: the old position is now caught (14/14 detected).
    - Both slicer projects re-sliced headless; times unchanged.
    - Renders not regenerated (they still show the OLED centred).
2026-11-05 Case: LINE IN jack forward (v 150 -> 124), the inserted plug hit the audio board
    On the prototype the 6.35 plug's tip pokes out of the back of the jack and ran into
    the audio board. The jack now sits in front of the board, under the OLED, 0.5 mm lower
    (JACK_Z 12.5) to clear the OLED PCB. check_fit models the inserted plug (PLUG_LEN 32 mm)
    and wants >= 2 mm to Teensy/audio board (now 4.0); two new mutations catch the old spot
    and a 40 mm plug. Renders not redone.
